Sabercat-Robotics-4146-FRC/Master-CAD-2017/images/Drive Module.jpeg

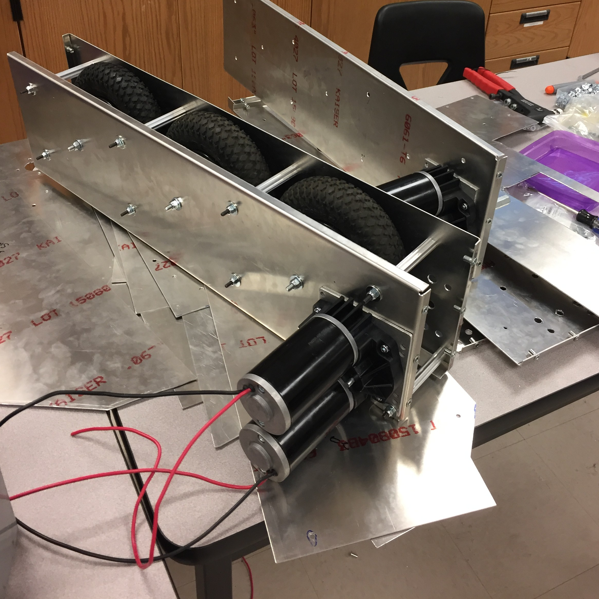
images/Drive Module.jpeg
