Sabercat-Robotics-4146-FRC/Master-CAD-2017/images/image01.png

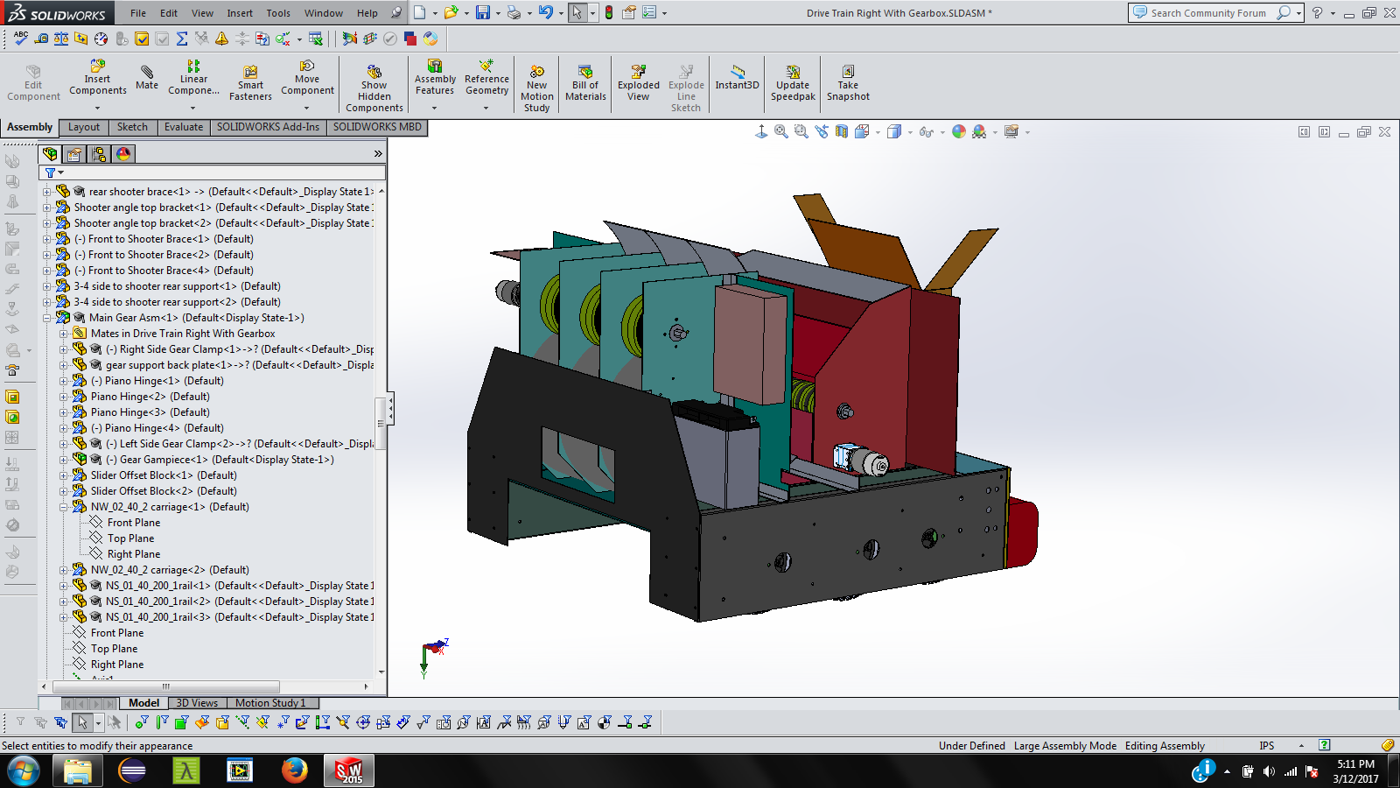
images/image01.png
