Sabercat-Robotics-4146-FRC/Master-CAD-2017/images/image02.png

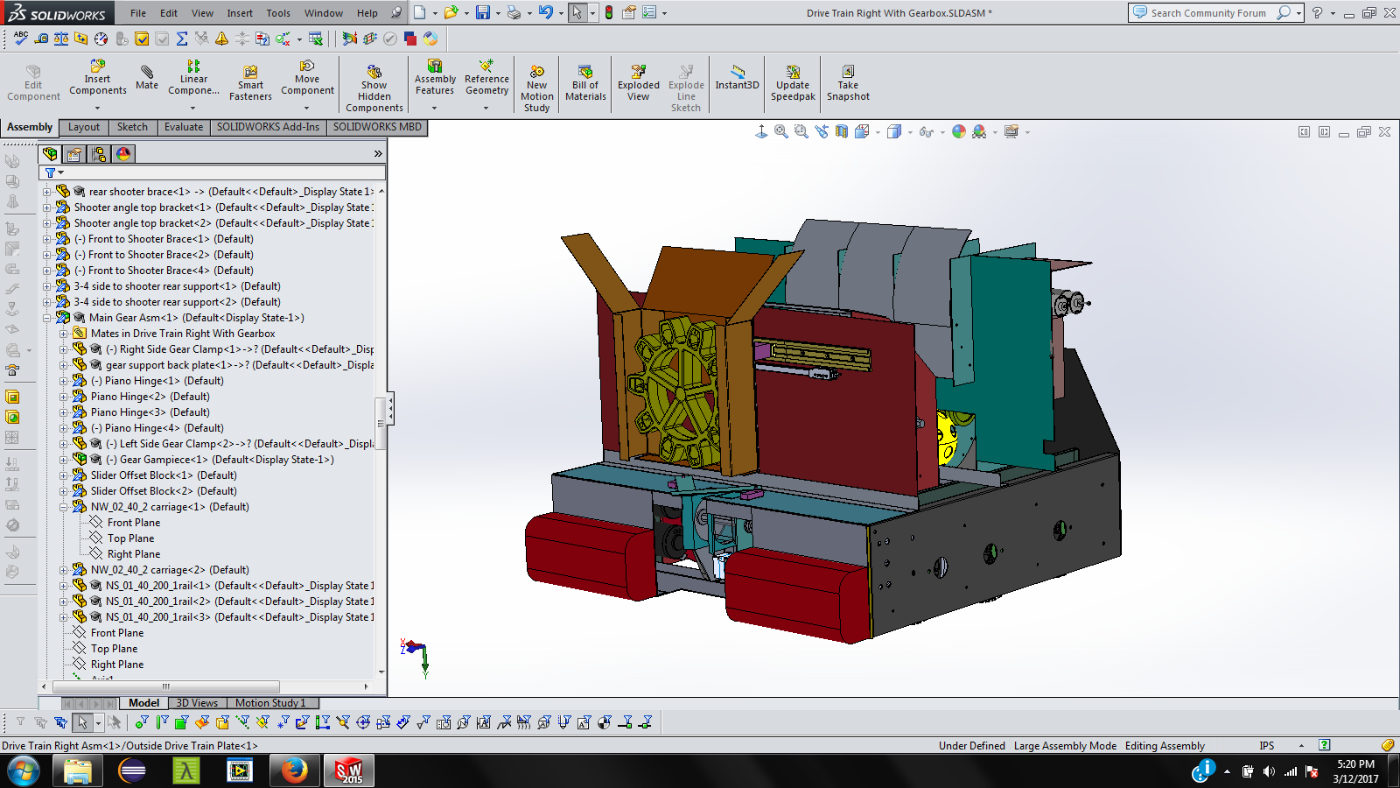
images/image02.png
