Sabercat-Robotics-4146-FRC/Master-CAD-2017/images/image03.png

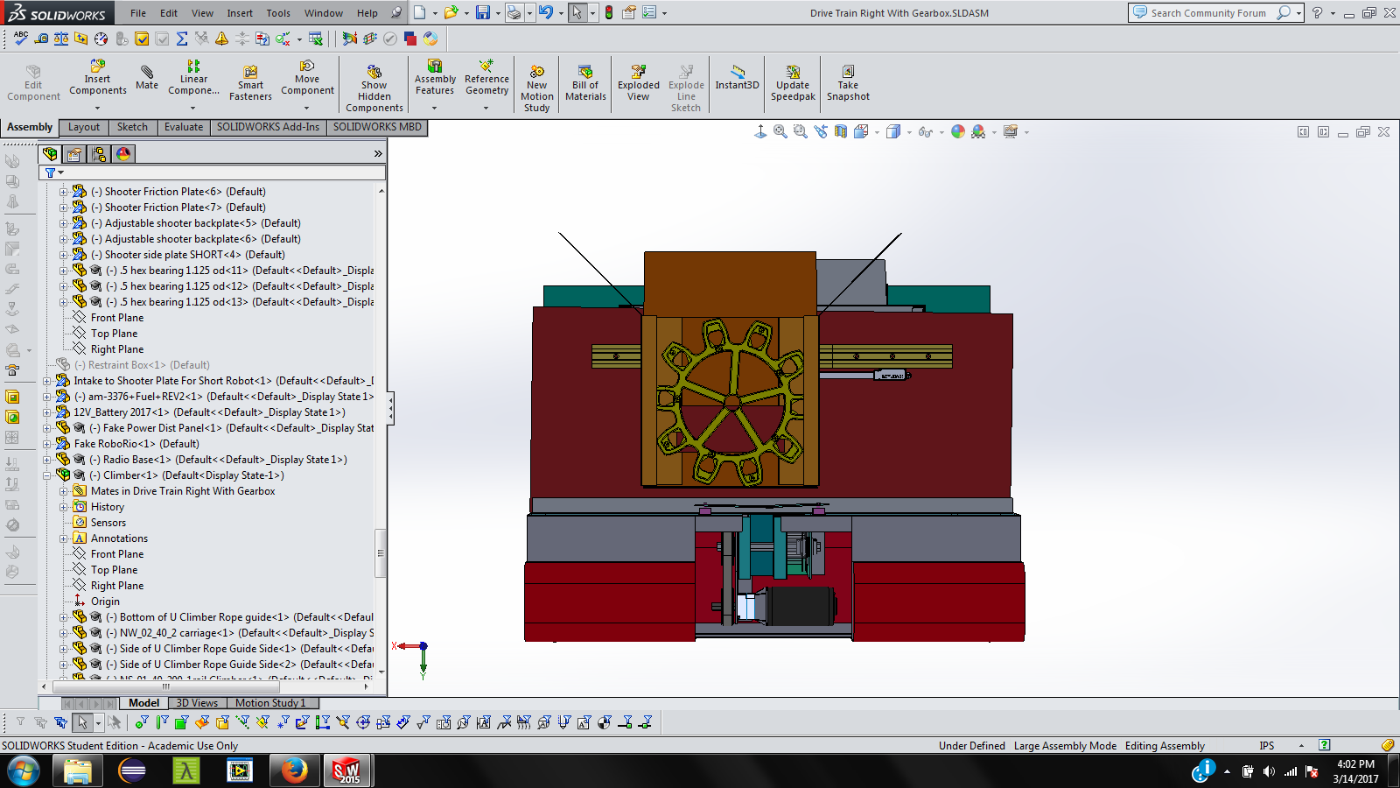
images/image03.png
