Sabercat-Robotics-4146-FRC/Master-CAD-2017/images/Pixy.jpg

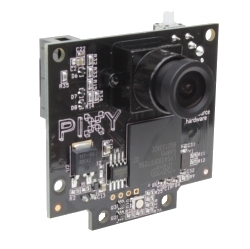
images/Pixy.jpg
