Sabercat-Robotics-4146-FRC/Master-CAD-2017/images/roboRIO-to-Pixy SPI connection configuration.jpg

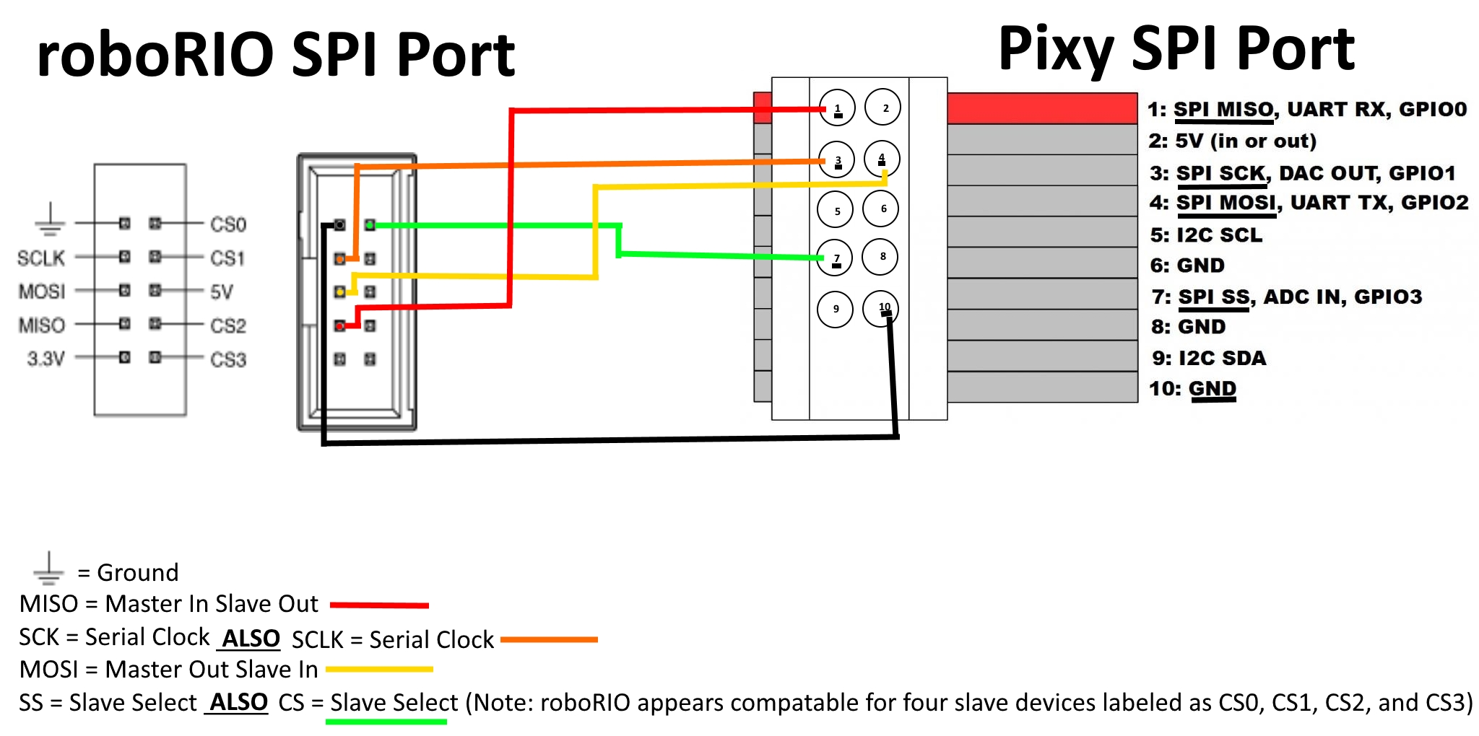
images/roboRIO-to-Pixy SPI connection configuration.jpg
