Sabercat-Robotics-4146-FRC/Master-CAD-2017/images/Robot Iso View crop.png

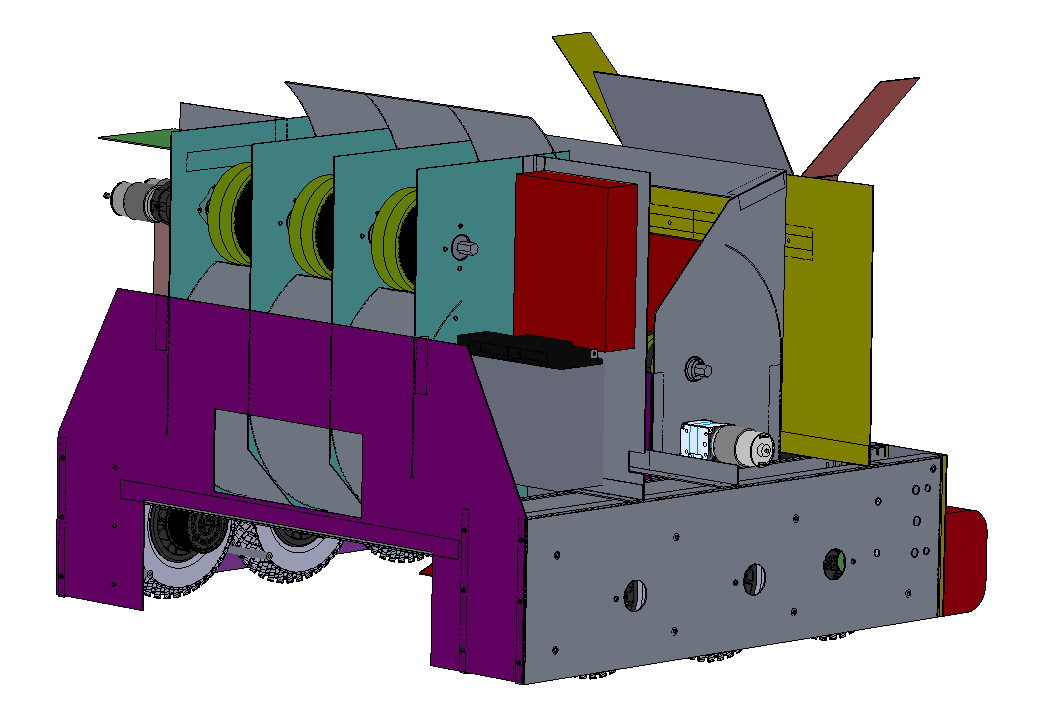
images/Robot Iso View crop.png
