Sabercat-Robotics-4146-FRC/Master-CAD-2017/Intake.SLDASM

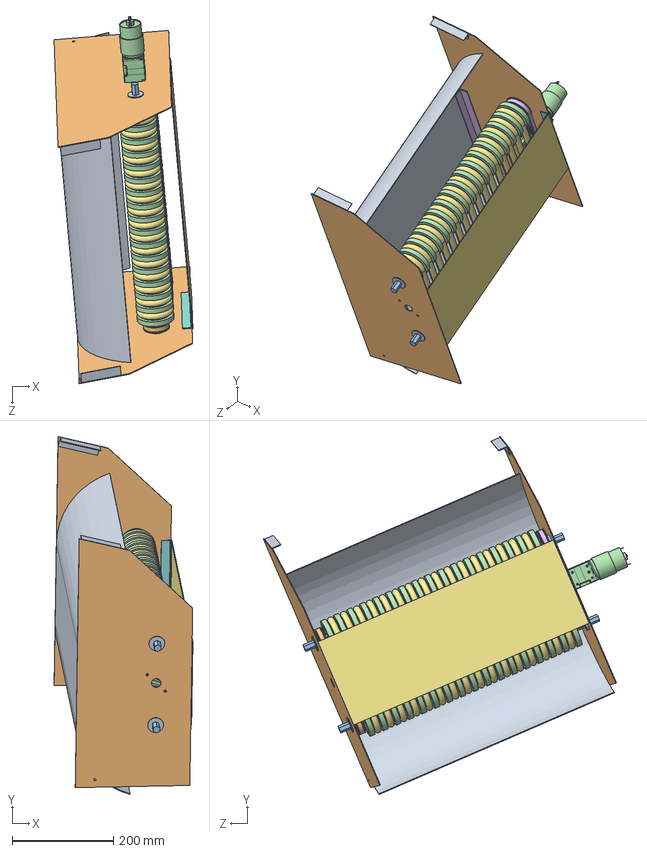
[picture p15: CAD file, 2017-07-01]
Intake.SLDASM
274.3 x 706.9 x 725.6 mm
Intake Backing Plate
Intake Side Plate x 2
Hex Shaft 22in for intake x 2
Banebots T40P 2-875 x 34
Banebots T40P 1-875 x 32
Intake Box Spine x 2
Intake Front Plate
Intake Box Front Rail x 2
.5 hex bearing 1.125 od x 4
Intake Drive Belt
VEXpro_VersaPlanetary_with_RS775
Primary Intake Drive Belt
Conveyor Tube Belt x 16
1-2 Intake brace x 2
3-4 brace for top intake x 2
