Sabercat-Robotics-4146-FRC/Master-CAD-2017/Pneumatic Wheel.SLDASM

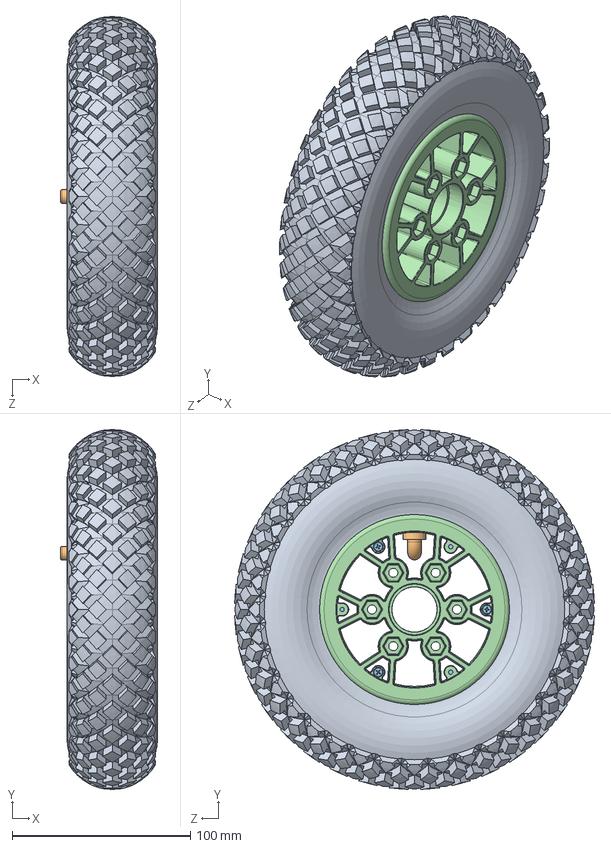
[picture p16: CAD file, 2017-07-01]
Pneumatic Wheel.SLDASM
54.4 x 202.1 x 202.1 mm
Tire
Valve
#4x1.00, Plastic Thread Rolling Screw, Pan Head, Cross Recessed, Zinc Plated (Plastic Applications)_ x 6
Hub x 2
