Sabercat-Robotics-4146-FRC/Master-CAD-2017/217-4008-STEP-20140807.SLDASM

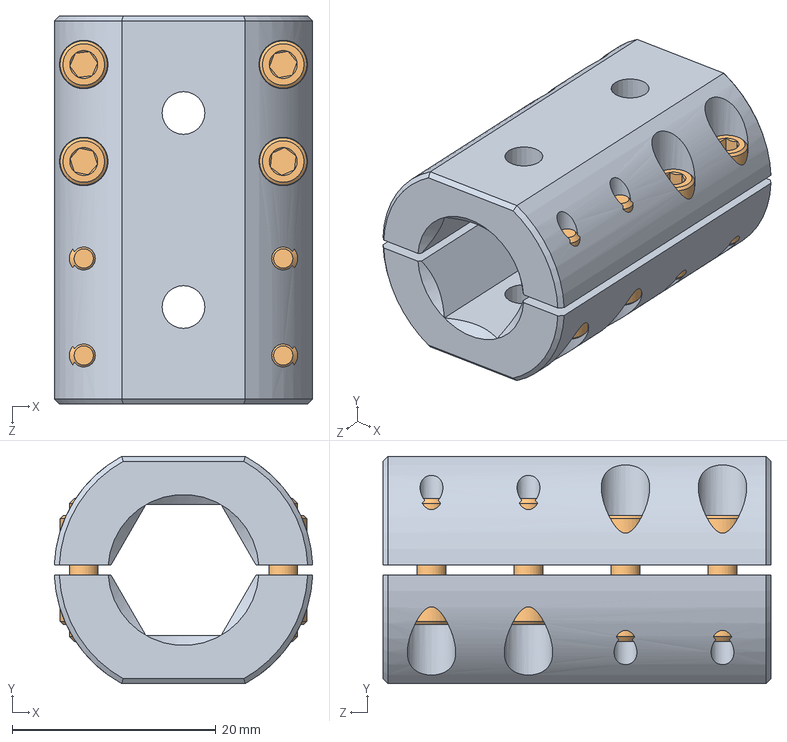
[picture p17: CAD file, 2017-07-01]
217-4008-STEP-20140807.SLDASM
25.4 x 22.3 x 38.1 mm
217-4008-001 Rev1 x 2
217-4008-002 Rev1_91251A108 x 8
