Sabercat-Robotics-4146-FRC/Master-CAD-2017/Snow Blower Motor True.SLDASM

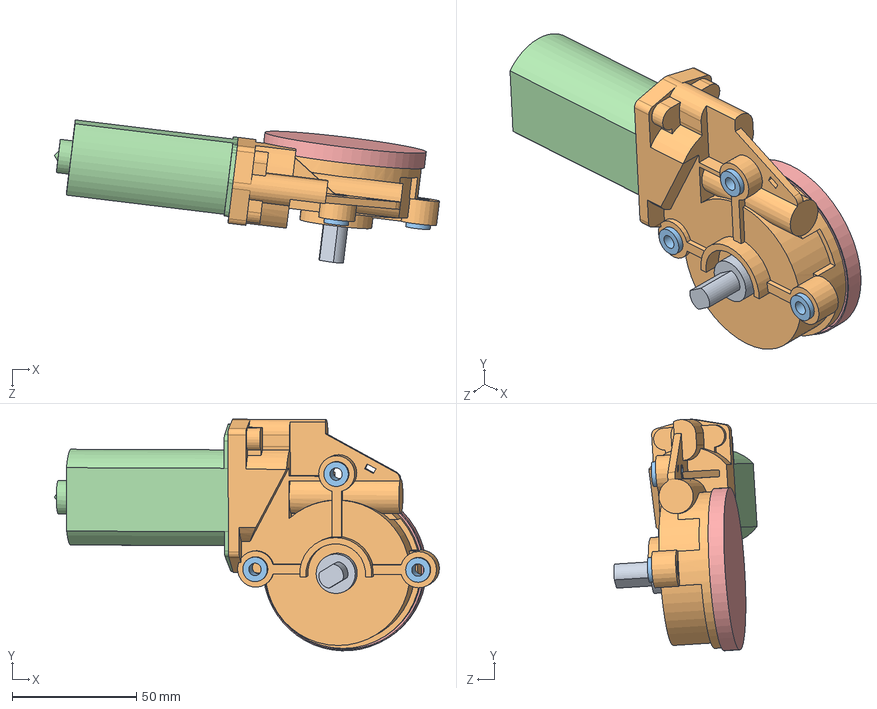
[picture p18: CAD file, 2017-07-01]
Snow Blower Motor True.SLDASM
154.8 x 93.1 x 57.6 mm
AM-2235 output shaft
AM-2235 gearbox housing
AM-2235 threaded insert x 3
AM-2235 motor
AM-2235 gear cap
