Sabercat-Robotics-4146-FRC/Master-CAD-2017/Main Gear Asm.SLDASM

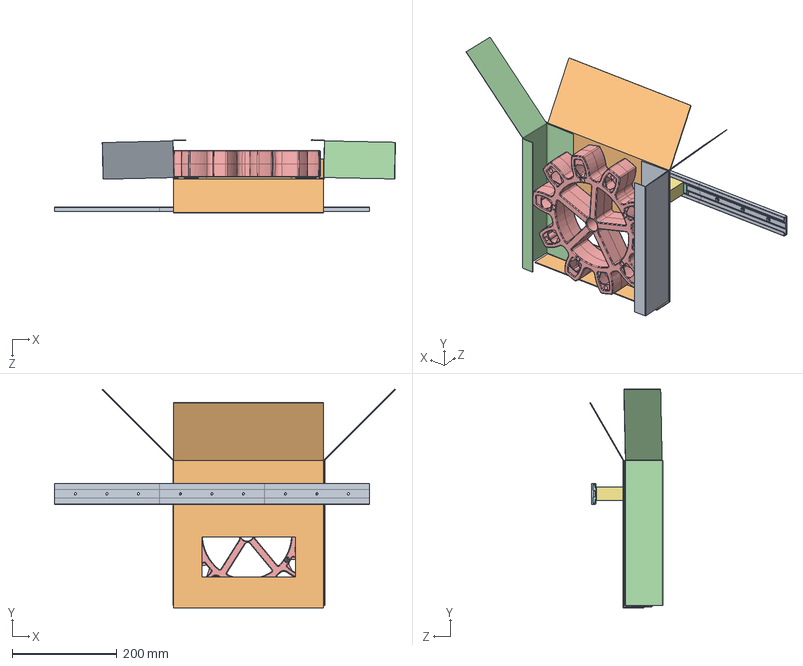
[picture p19: CAD file, 2017-07-01]
Main Gear Asm.SLDASM
649.7 x 416.4 x 139.9 mm
Right Side Gear Clamp
gear support back plate
Piano Hinge x 4
Left Side Gear Clamp
ip-3302 10T gear x 2
am-1291 screw_90190A196 x 20
Slider Offset Block x 2
NW_02_40_2 carriage x 2
NS_01_40_200_1rail x 3
