Sabercat-Robotics-4146-FRC/Master-CAD-2017/Climber Guide.SLDASM

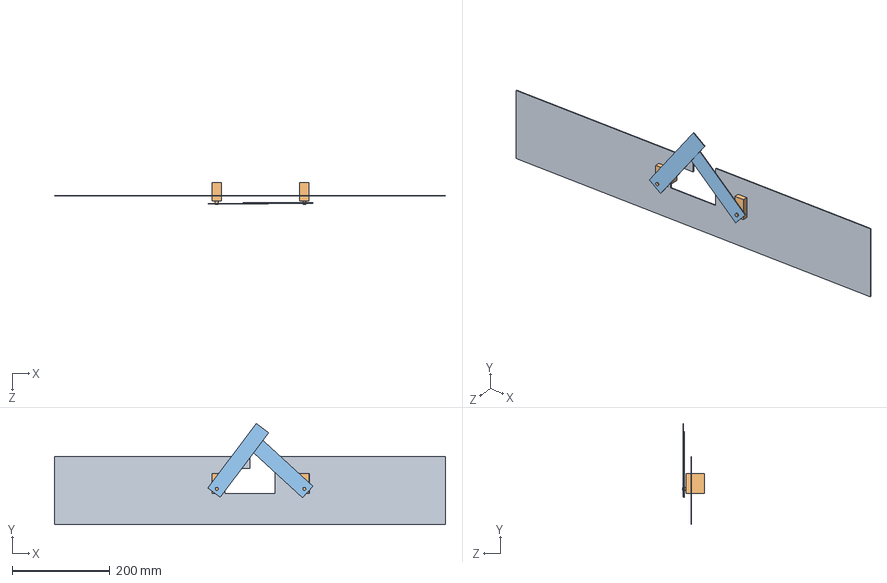
[picture p20: CAD file, 2017-07-01]
Climber Guide.SLDASM
800.1 x 206.9 x 46.0 mm
Climber Guide Baseplate
Fake Servo Tactic TSX45 x 2
Servo Arm x 2
