Sabercat-Robotics-4146-FRC/Master-CAD-2017/CIM motor with versa planetary adapter.SLDASM

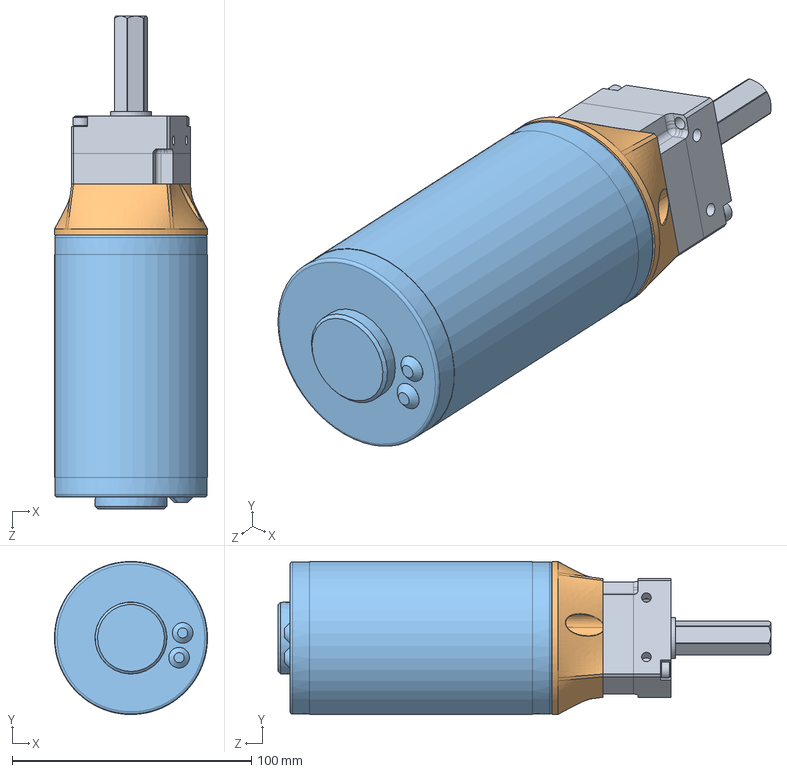
[picture p21: CAD file, 2017-07-01]
CIM motor with versa planetary adapter.SLDASM
64.0 x 64.0 x 206.2 mm
Climber Gearbox for CIM
217-4018 Versa Planetary CIM Adapter
CIM MOTOR
