Sabercat-Robotics-4146-FRC/Master-CAD-2017/Gear Gampiece.SLDASM

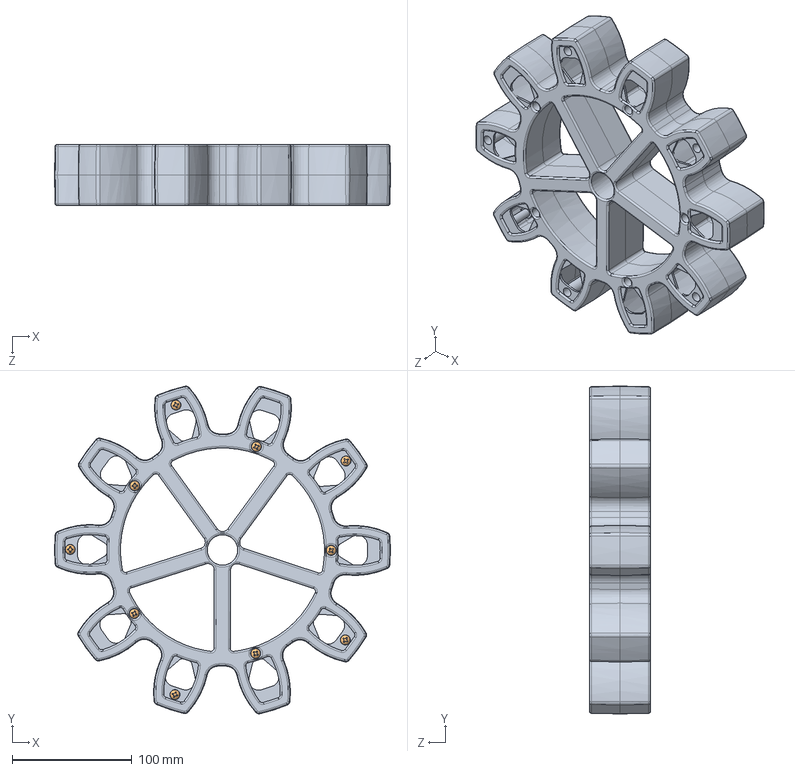
[picture p22: CAD file, 2017-07-01]
Gear Gampiece.SLDASM
280.3 x 273.4 x 50.8 mm
ip-3302 10T gear x 2
am-1291 screw_90190A196 x 20
