Sabercat-Robotics-4146-FRC/Master-CAD-2017/servo.SLDASM

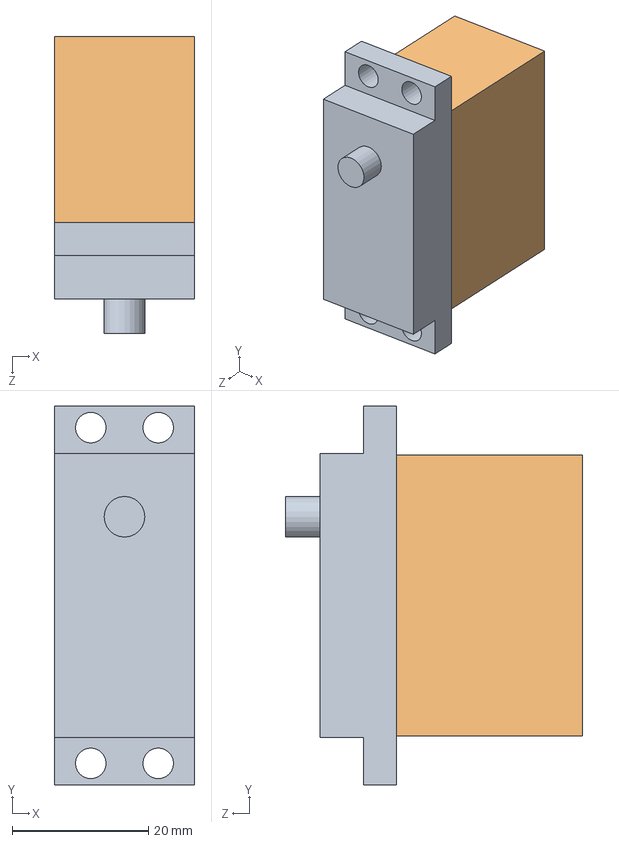
[picture p23: CAD file, 2017-07-01]
servo.SLDASM
20.6 x 55.6 x 43.6 mm
Servo mounting block
Servo base block
