Sabercat-Robotics-4146-FRC/Master-CAD-2017/Wheel Asm.SLDASM

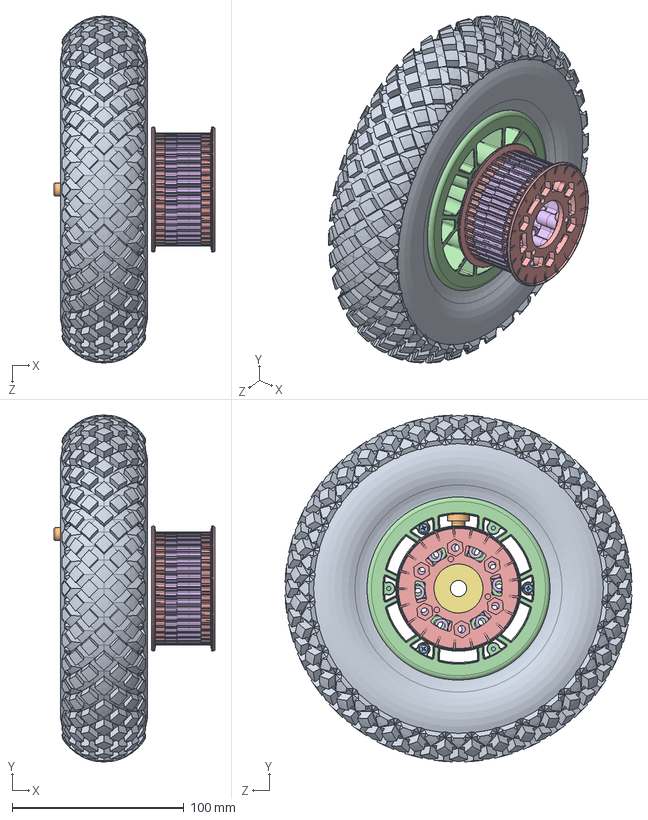
[picture p24: CAD file, 2017-07-01]
Wheel Asm.SLDASM
93.7 x 202.1 x 202.1 mm
Tire
Valve
#4x1.00, Plastic Thread Rolling Screw, Pan Head, Cross Recessed, Zinc Plated (Plastic Applications)_ x 6
Hub x 2
Outer Pulley x 2
Center Pulley x 3
1.125 od .375 id bearing x 2
