Sabercat-Robotics-4146-FRC/Master-CAD-2017/Toughbox-mini.SLDASM

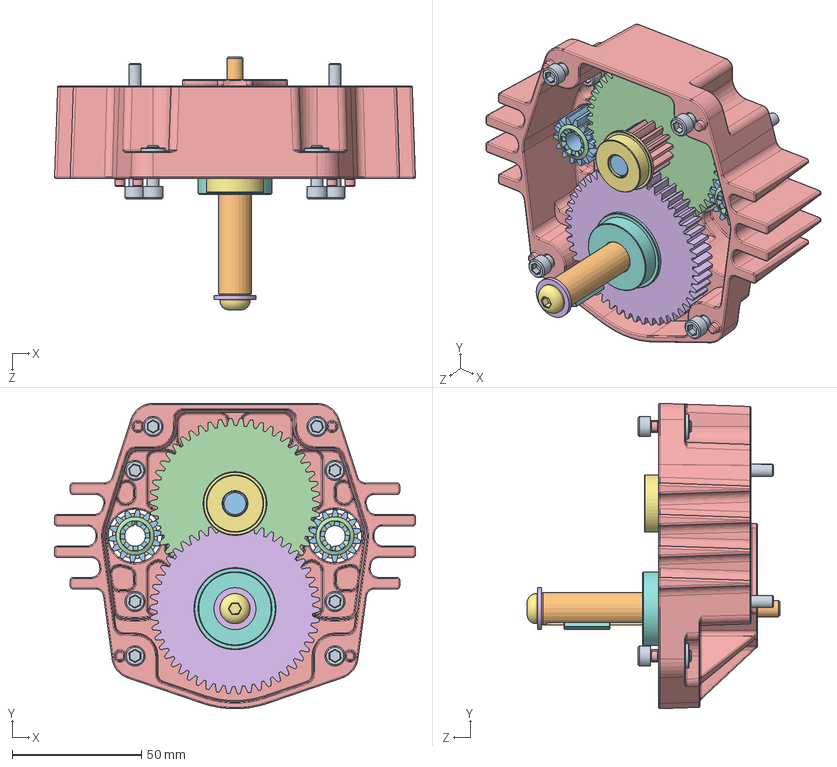
[picture p25: CAD file, 2017-07-01]
Toughbox-mini.SLDASM
139.9 x 118.3 x 98.0 mm
r6zz x 2
Toughbox_d03
Toughbox_d07
Toughbox_d05
Toughbox_d08
Toughbox_d06
fr-6-zz
fr-8-zz
10-32_nylock_nut x 4
5-16_washer x 4
Toughbox_d09 x 2
8mm_spring_clip x 2
Toughbox-mini_d01-5-12
250_washer
14-20x0500_bhcs
125x124x700_key
10-32x0625_shcs x 8
