Sabercat-Robotics-4146-FRC/Master-CAD-2017/Climber.SLDASM

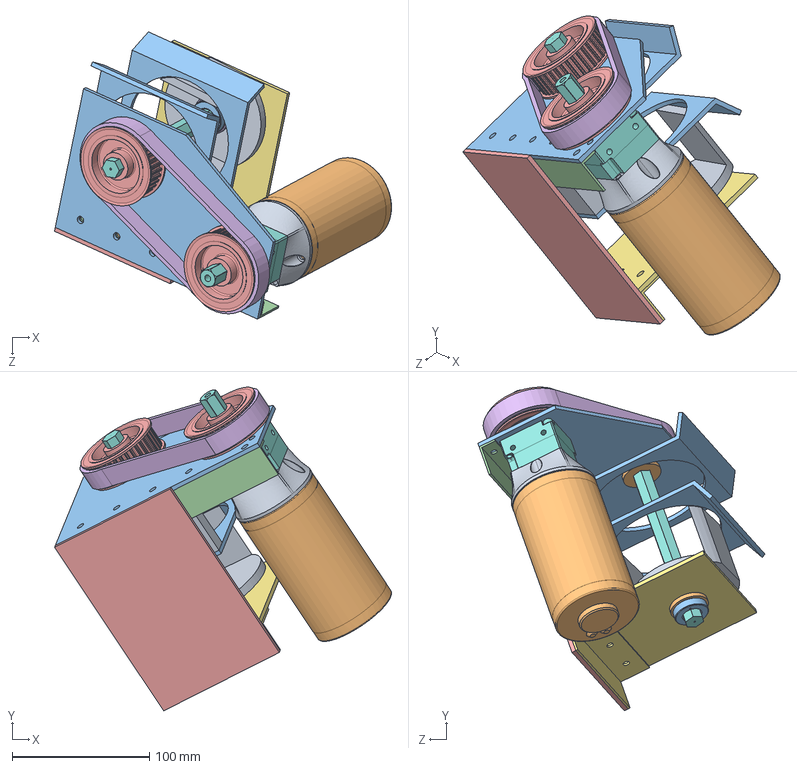
[picture p26: CAD file, 2017-07-01]
Climber.SLDASM
245.1 x 235.5 x 209.0 mm
Bottom of U Climber Rope guide
NW_02_40_2 carriage
Side of U Climber Rope Guide Side x 2
NS_01_40_200_1rail Climber
Climber Baseplate
Versa Hub 1-2 Hex
Climber Rope Sideplate
Climber Hex Shaft
Climber Rope Winder
.5 hex bearing 1.125 od x 2
217-2737 Shaft Collar x 2
Angle Piece for Climber Side Plate
217-3232 Timing Pulley 36T 15mm x 2
Climber Belt 60T (36T pulley)
Angle Piece for Climber Side Plate uncut
Climber Gearbox for CIM
217-4018 Versa Planetary CIM Adapter
CIM MOTOR
Climber Rope Sideplate with motor
