Sabercat-Robotics-4146-FRC/Master-CAD-2017/2017 Robot Intake Asm.SLDASM

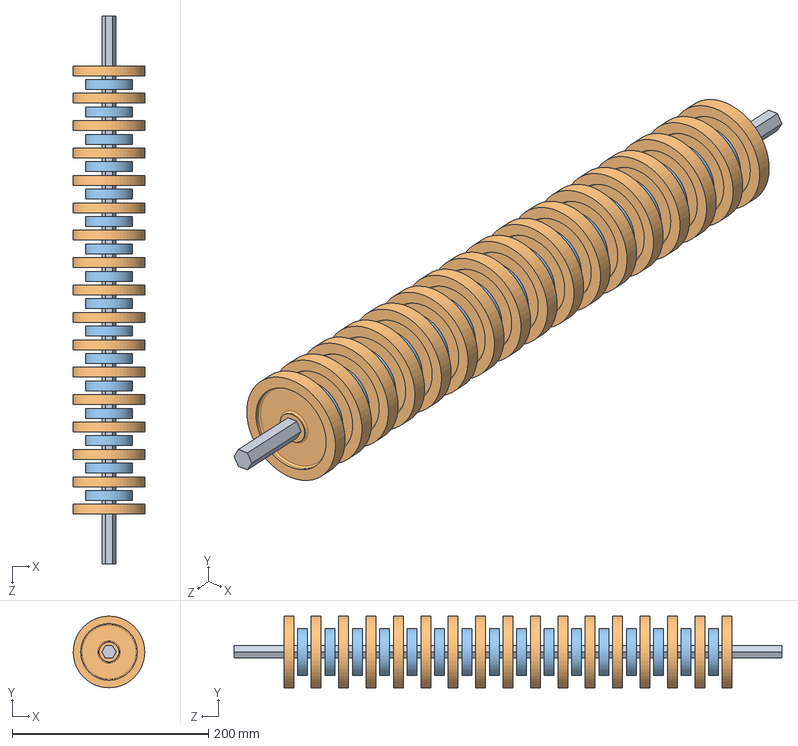
[picture p27: CAD file, 2017-07-01]
2017 Robot Intake Asm.SLDASM
73.0 x 73.0 x 558.8 mm
Hex Shaft 22in for intake
Banebots T40P 2-875 x 17
Banebots T40P 1-875 x 16
