Sabercat-Robotics-4146-FRC/Master-CAD-2017/Drive Train Left Asm.SLDASM

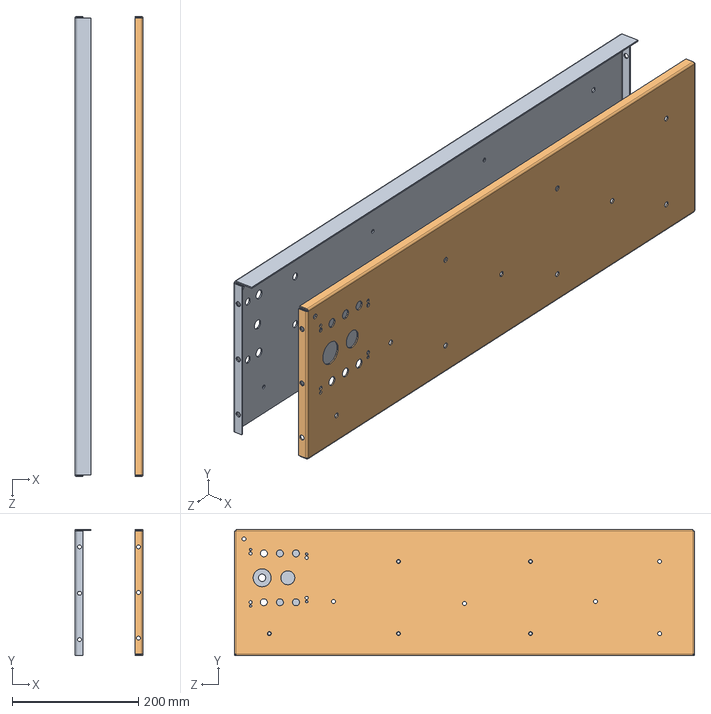
[picture p28: CAD file, 2017-07-01]
Drive Train Left Asm.SLDASM
108.4 x 200.2 x 728.6 mm
Outside Drive Train Plate Left
Inner Drive Train Plate Left
