Sabercat-Robotics-4146-FRC/Master-CAD-2017/217-3141-RS775-STEP.SLDASM

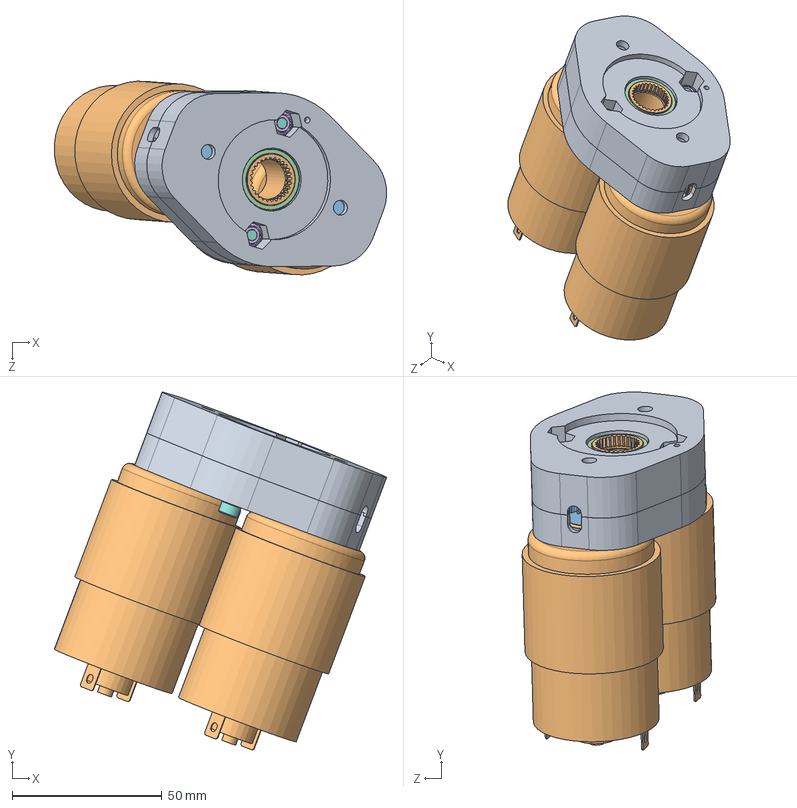
[picture p29: CAD file, 2017-07-01]
217-3141-RS775-STEP.SLDASM
110.8 x 119.3 x 64.6 mm
217-3141-001 Rev1
217-3141-007 Rev1_30T 32DP
217-3141-006 Rev1_30T 32DP x 2
SSS1032-0188-ZB x 2
NUT-832-NYLOCK x 2
SSA_SSAM4-0010ZC x 4
SSA_SSA0832-0750ZC x 2
217-3141-004 Rev1
BB RS775-18V x 2
217-2625-013 Rev1 x 2
