Sabercat-Robotics-4146-FRC/Master-CAD-2017/Climber Rope Sideplate with motor.SLDPRT

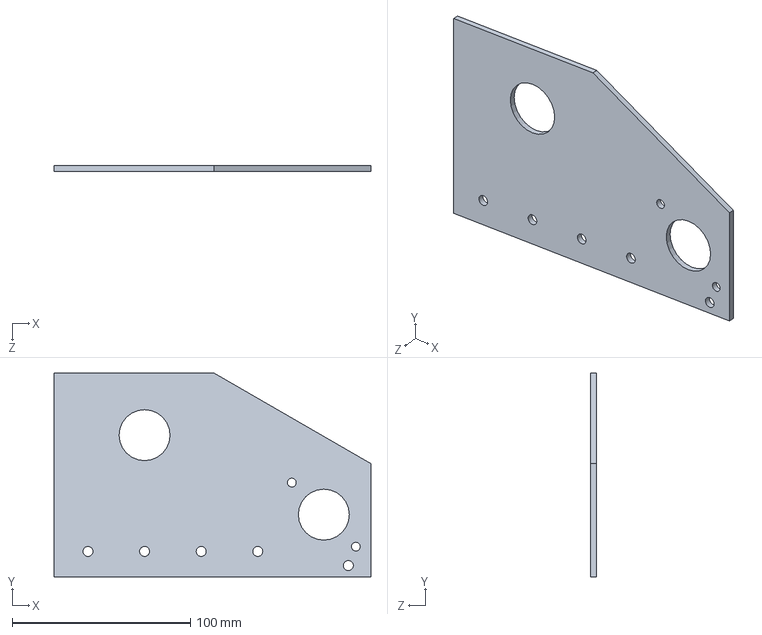
[picture p30: CAD file, 2017-07-01]
Climber Rope Sideplate with motor.SLDPRT
177.8 x 114.3 x 3.17 mm
