Sabercat-Robotics-4146-FRC/Master-CAD-2017/Back Belly Pan Diagonal.SLDPRT

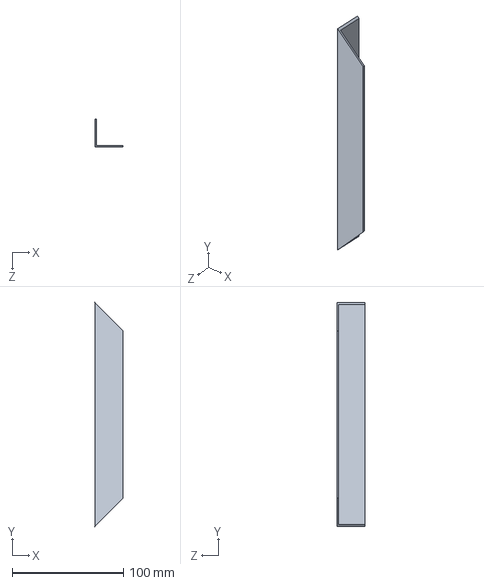
[picture p31: CAD file, 2017-07-01]
Back Belly Pan Diagonal.SLDPRT
25.4 x 200.9 x 25.4 mm
