Sabercat-Robotics-4146-FRC/Master-CAD-2017/rear shooter brace.SLDPRT

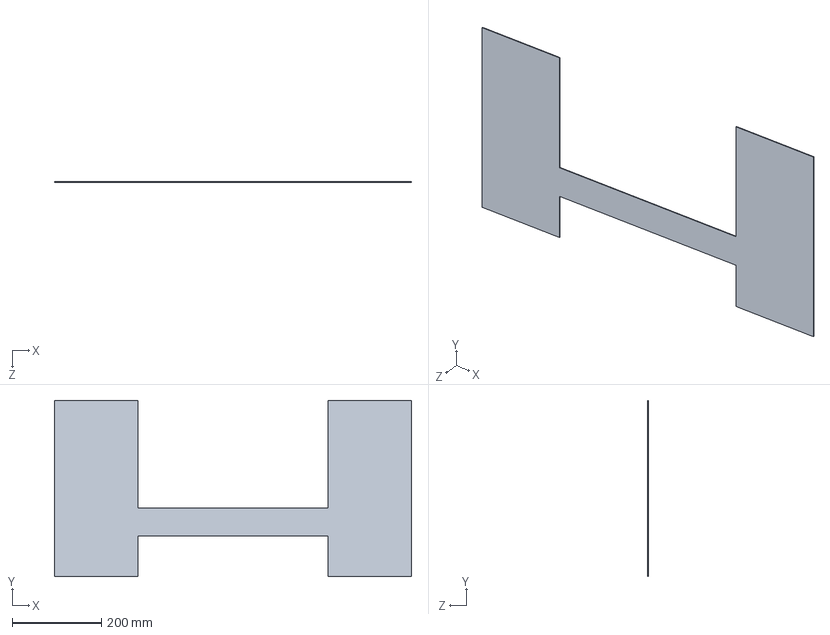
[picture p32: CAD file, 2017-07-01]
rear shooter brace.SLDPRT
800.1 x 394.5 x 1.59 mm
