Sabercat-Robotics-4146-FRC/Master-CAD-2017/Hex Shaft 22in for intake.SLDPRT

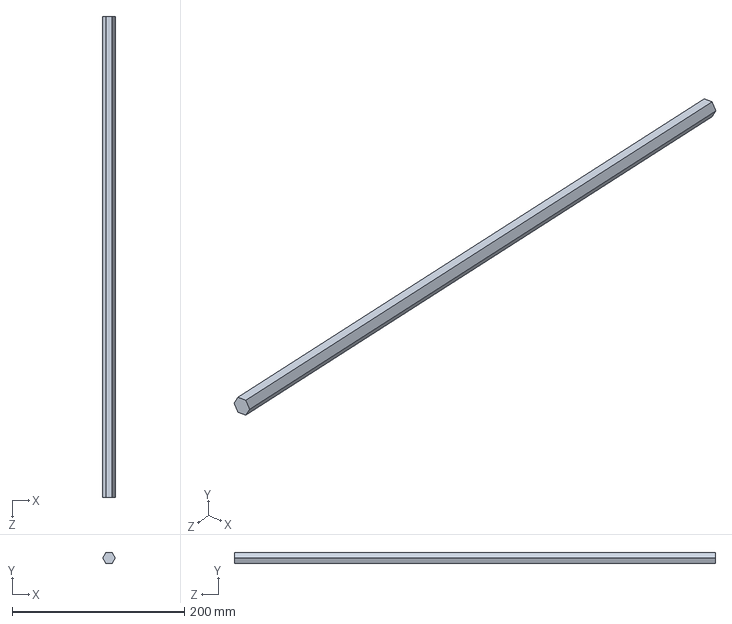
[picture p33: CAD file, 2017-07-01]
Hex Shaft 22in for intake.SLDPRT
14.7 x 12.7 x 558.8 mm
