Sabercat-Robotics-4146-FRC/Master-CAD-2017/Right Side Gear Clamp.SLDPRT

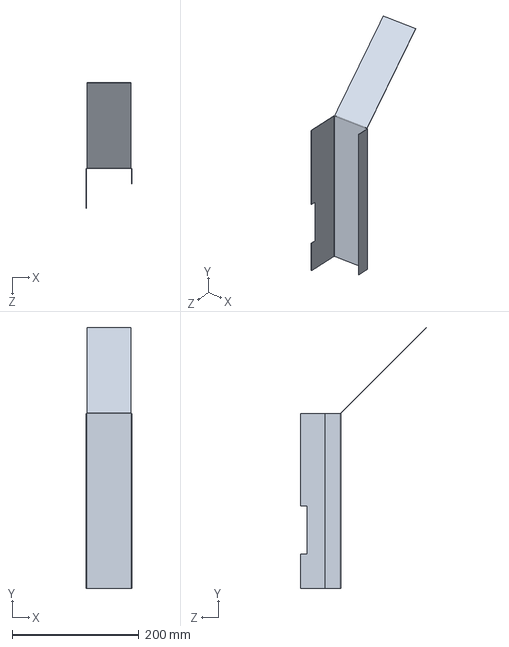
[picture p34: CAD file, 2017-07-01]
Right Side Gear Clamp.SLDPRT
72.6 x 411.1 x 198.0 mm
