Sabercat-Robotics-4146-FRC/Master-CAD-2017/Adjustable shooter backplate.SLDPRT

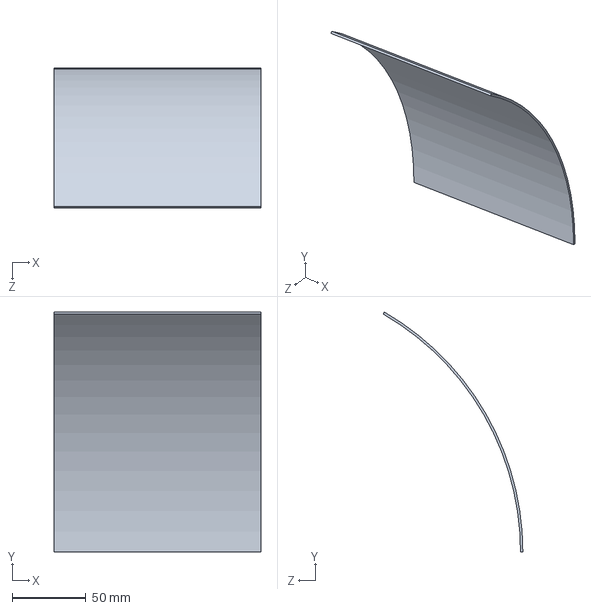
[picture p35: CAD file, 2017-07-01]
Adjustable shooter backplate.SLDPRT
139.7 x 162.2 x 94.4 mm
