Sabercat-Robotics-4146-FRC/Master-CAD-2017/217-4018 Versa Planetary CIM Adapter.SLDPRT

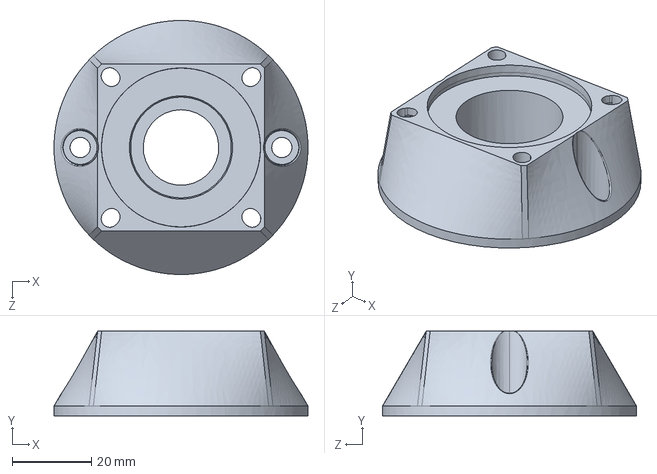
[picture p36: CAD file, 2017-07-01]
217-4018 Versa Planetary CIM Adapter.SLDPRT
64.0 x 21.4 x 64.0 mm
