Sabercat-Robotics-4146-FRC/Master-CAD-2017/NW_02_40_2 carriage.SLDPRT

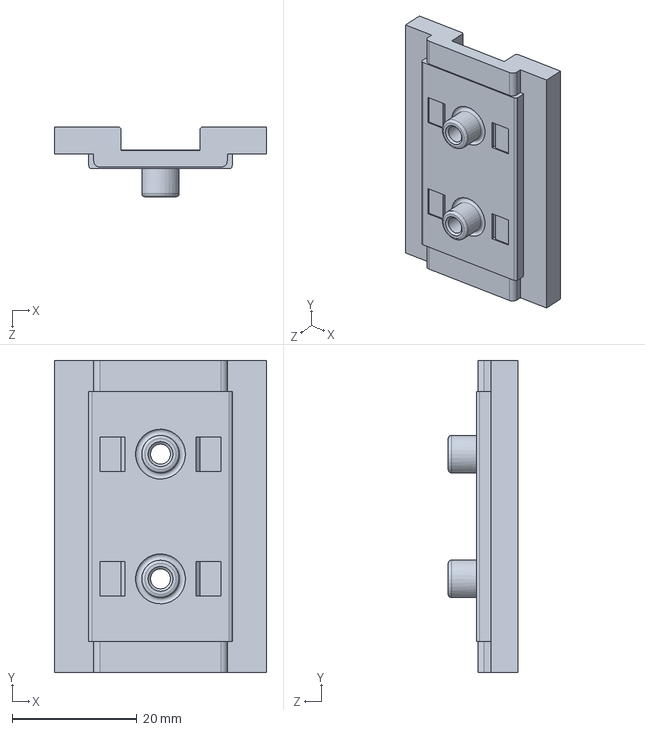
[picture p37: CAD file, 2017-07-01]
NW_02_40_2 carriage.SLDPRT
34.0 x 50.0 x 11.2 mm
