Sabercat-Robotics-4146-FRC/Master-CAD-2017/Restraint Box.SLDPRT

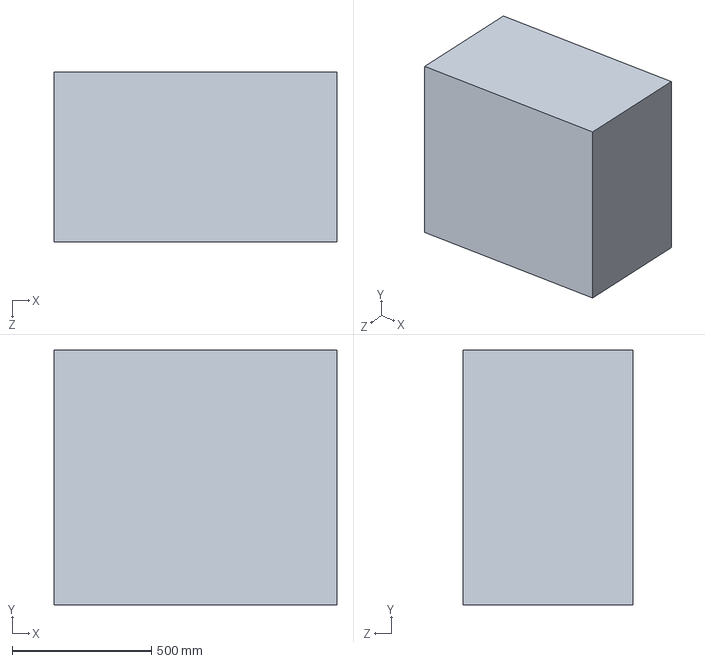
[picture p38: CAD file, 2017-07-01]
Restraint Box.SLDPRT
1016.0 x 914.4 x 609.6 mm
