Sabercat-Robotics-4146-FRC/Master-CAD-2017/Gear_v2_mock pivot hinge leaf only.SLDPRT

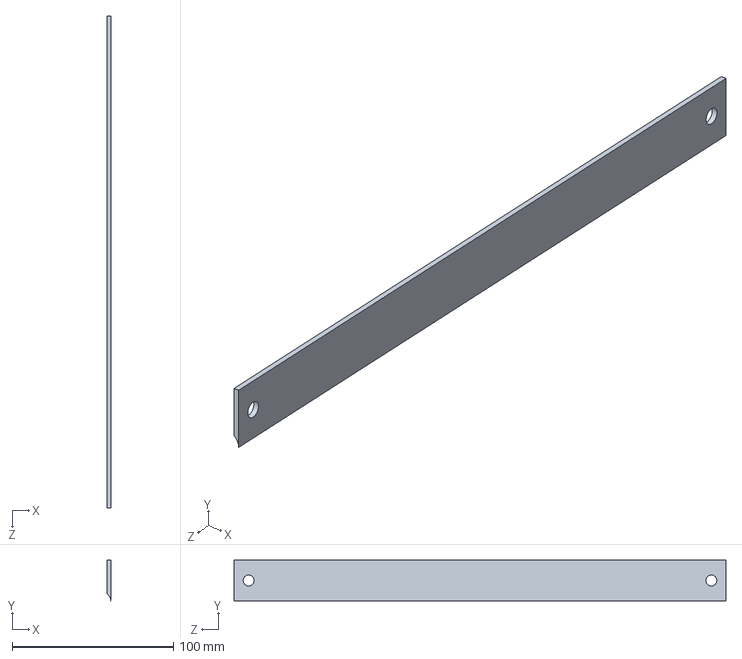
[picture p39: CAD file, 2017-07-01]
Gear_v2_mock pivot hinge leaf only.SLDPRT
2.29 x 25.4 x 304.8 mm
