Sabercat-Robotics-4146-FRC/Master-CAD-2017/CIM MOTOR.SLDPRT

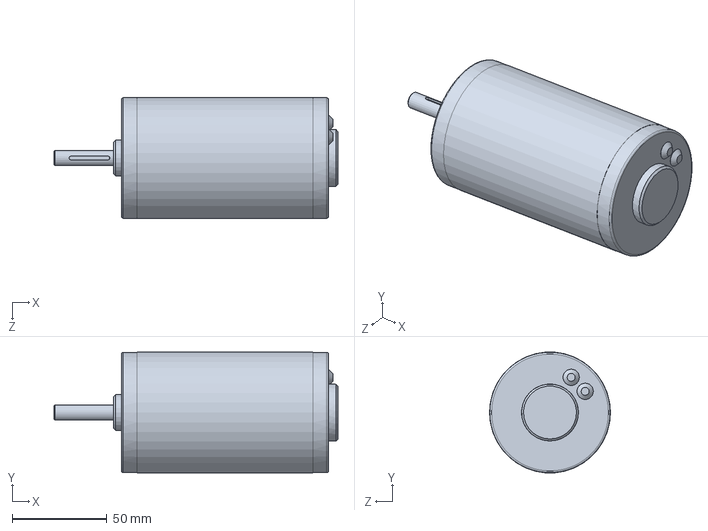
[picture p40: CAD file, 2017-07-01]
CIM MOTOR.SLDPRT
150.2 x 63.8 x 64.0 mm
