Sabercat-Robotics-4146-FRC/Master-CAD-2017/Versa Hub 1-2 Hex.SLDPRT

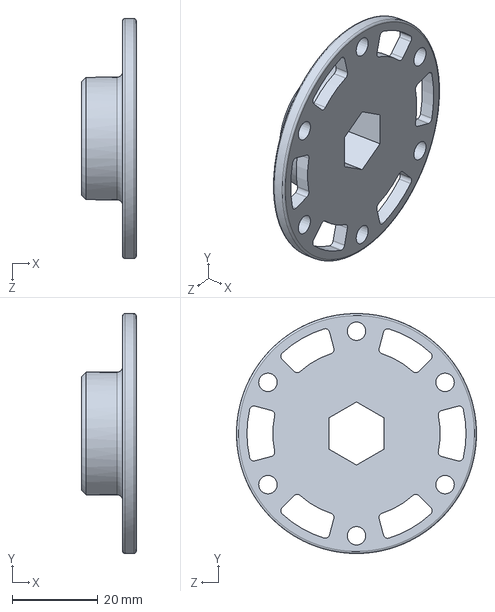
[picture p41: CAD file, 2017-07-01]
Versa Hub 1-2 Hex.SLDPRT
12.7 x 55.9 x 55.9 mm
