Sabercat-Robotics-4146-FRC/Master-CAD-2017/Toughbox-mini_d01-5-12.sldprt

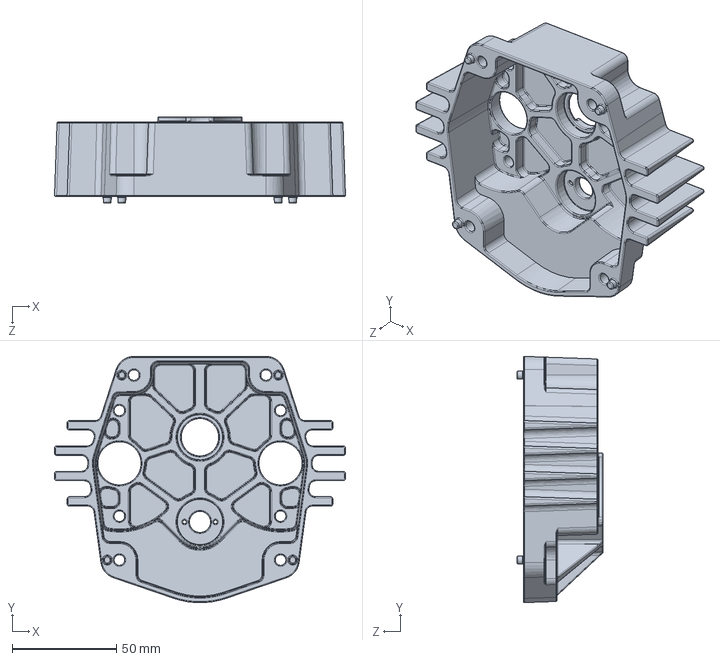
[picture p42: CAD file, 2017-07-01]
Toughbox-mini_d01-5-12.sldprt
139.9 x 118.3 x 41.5 mm
