Sabercat-Robotics-4146-FRC/Master-CAD-2017/am-3376+Fuel+REV2.SLDPRT

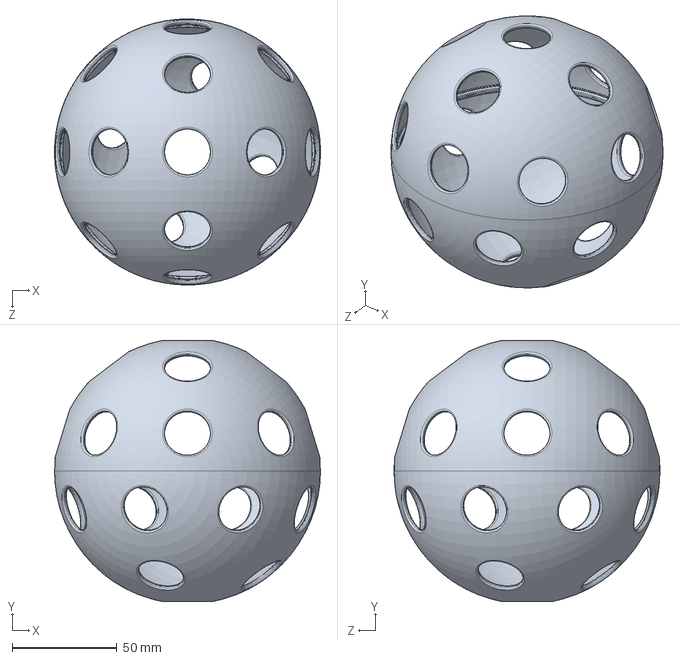
[picture p43: CAD file, 2017-07-01]
am-3376+Fuel+REV2.SLDPRT
127.0 x 124.8 x 127.0 mm
