Sabercat-Robotics-4146-FRC/Master-CAD-2017/Intake to Shooter Plate For Short Robot.SLDPRT

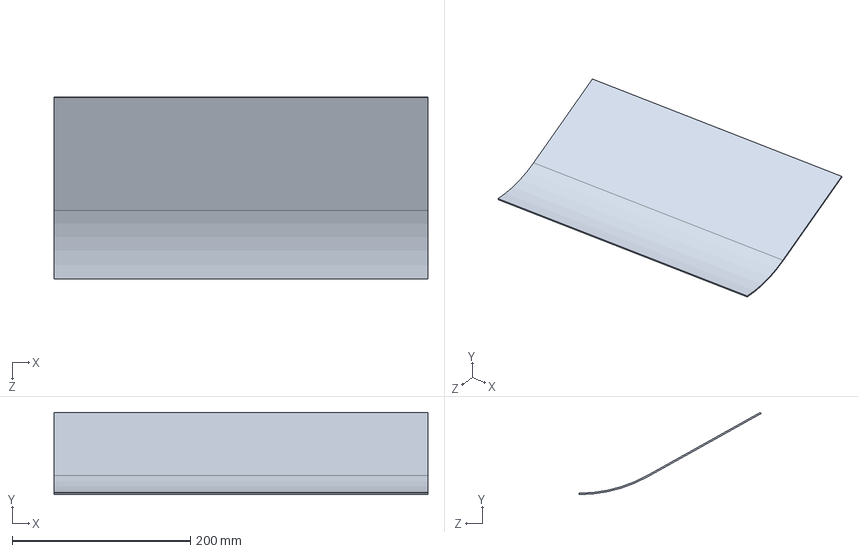
[picture p44: CAD file, 2017-07-01]
Intake to Shooter Plate For Short Robot.SLDPRT
419.1 x 92.1 x 204.0 mm
