Sabercat-Robotics-4146-FRC/Master-CAD-2017/Intake Box Spine.SLDPRT

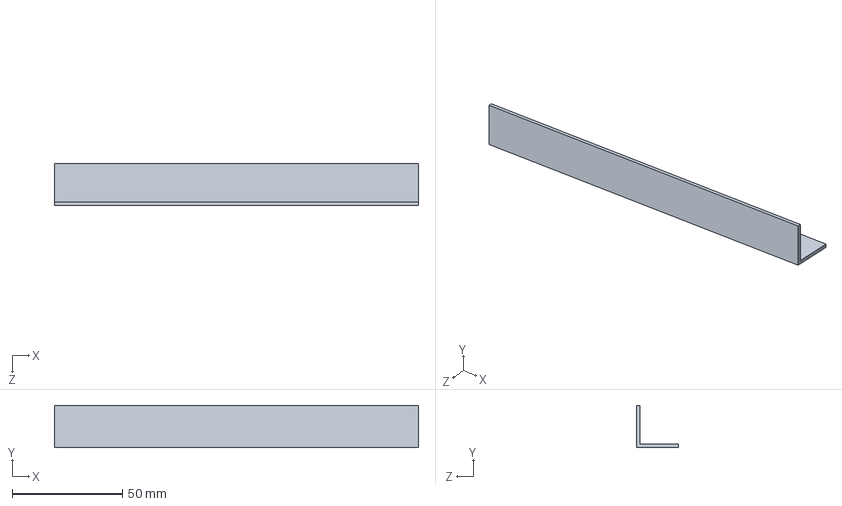
[picture p45: CAD file, 2017-07-01]
Intake Box Spine.SLDPRT
165.1 x 19.1 x 19.1 mm
