Sabercat-Robotics-4146-FRC/Master-CAD-2017/Servo Arm.SLDPRT

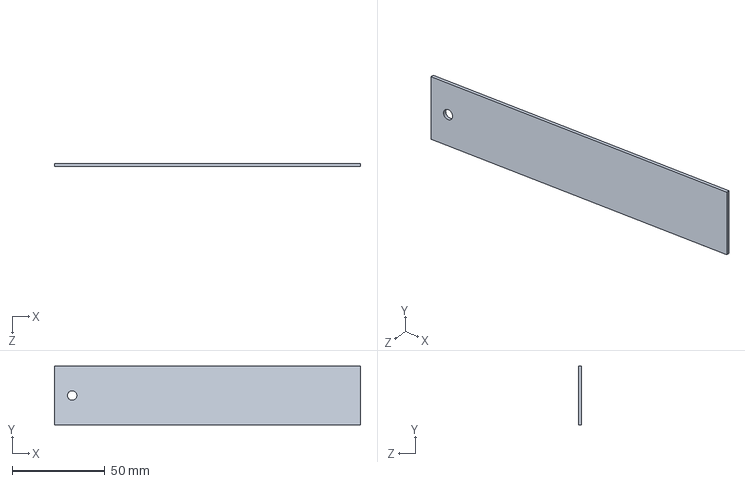
[picture p46: CAD file, 2017-07-01]
Servo Arm.SLDPRT
165.1 x 31.8 x 1.60 mm
