Sabercat-Robotics-4146-FRC/Master-CAD-2017/Shooter Feed Back Plate SHORT.SLDPRT

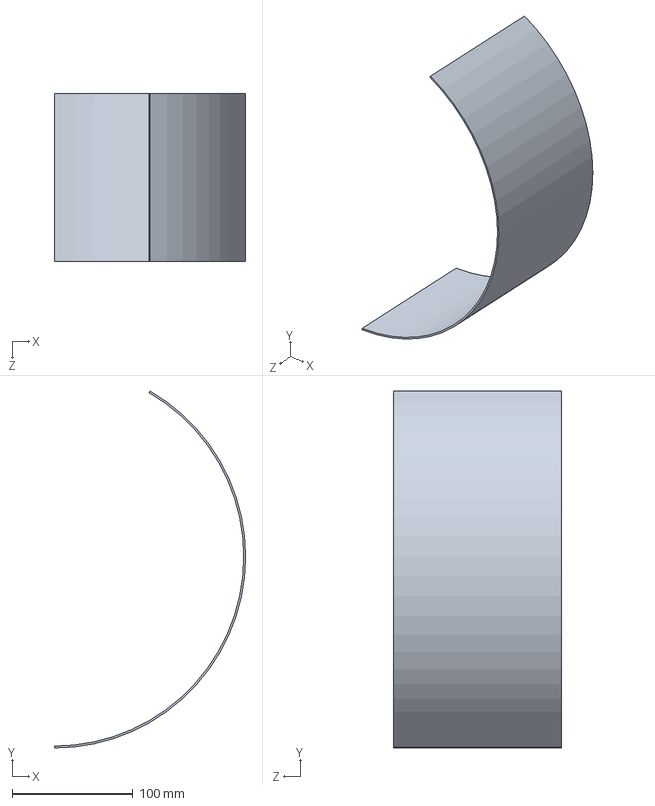
[picture p47: CAD file, 2017-07-01]
Shooter Feed Back Plate SHORT.SLDPRT
158.8 x 296.2 x 139.7 mm
