Sabercat-Robotics-4146-FRC/Master-CAD-2017/Intake Front Plate.SLDPRT

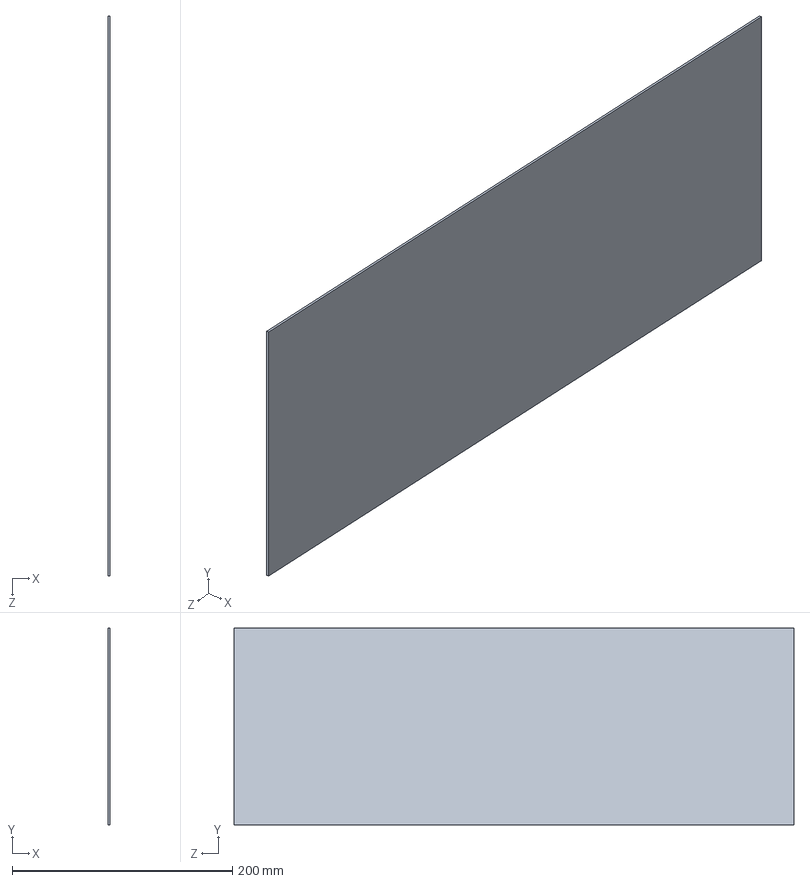
[picture p48: CAD file, 2017-07-01]
Intake Front Plate.SLDPRT
1.59 x 178.8 x 508.0 mm
