Sabercat-Robotics-4146-FRC/Master-CAD-2017/Intake Side Plate.SLDPRT

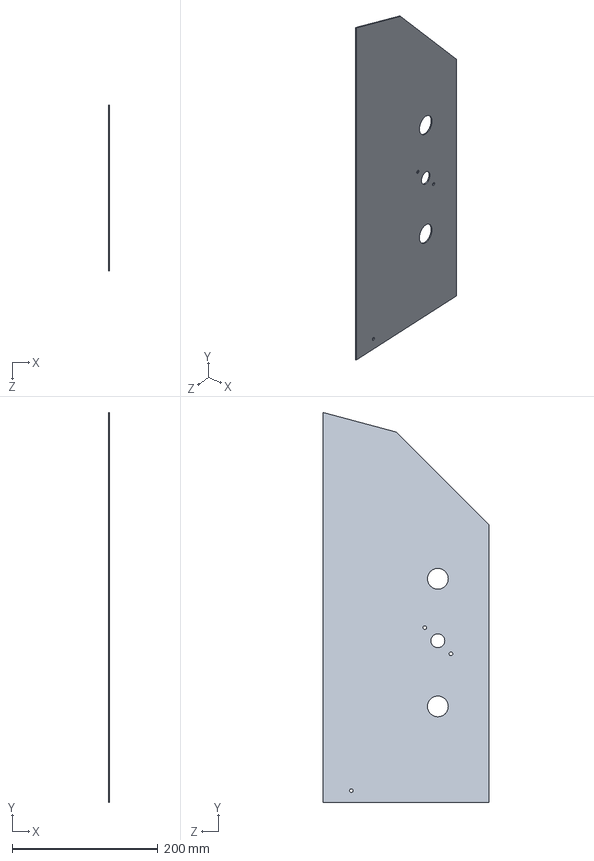
[picture p49: CAD file, 2017-07-01]
Intake Side Plate.SLDPRT
1.59 x 534.8 x 227.1 mm
