Sabercat-Robotics-4146-FRC/Master-CAD-2017/3-4 Door Connecting Bracket.SLDPRT

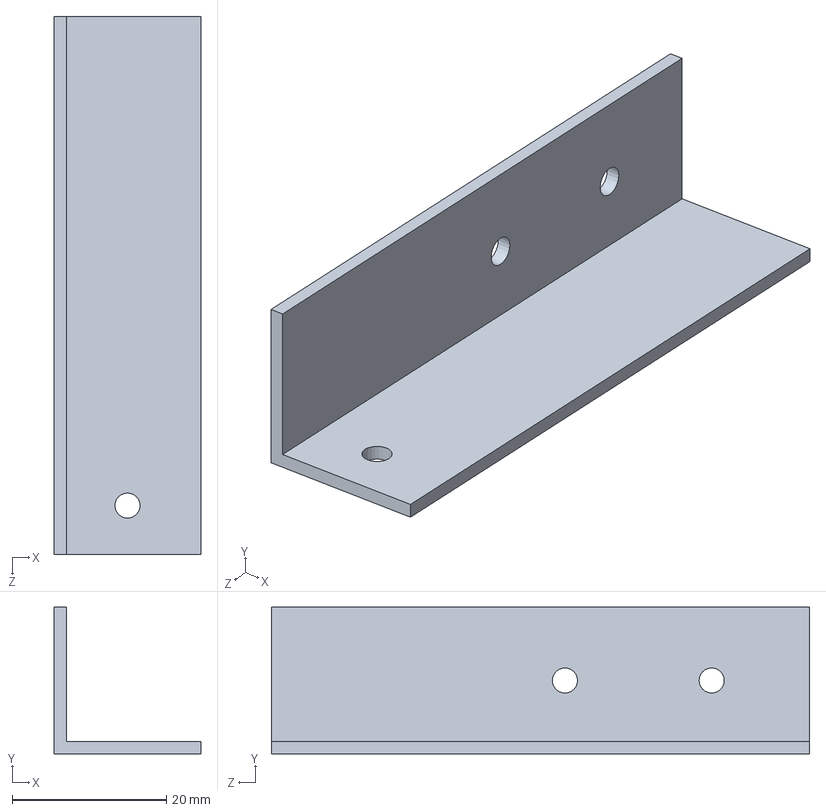
[picture p50: CAD file, 2017-07-01]
3-4 Door Connecting Bracket.SLDPRT
19.1 x 19.1 x 69.8 mm
