Sabercat-Robotics-4146-FRC/Master-CAD-2017/Climber Belt 60T (36T pulley).SLDPRT

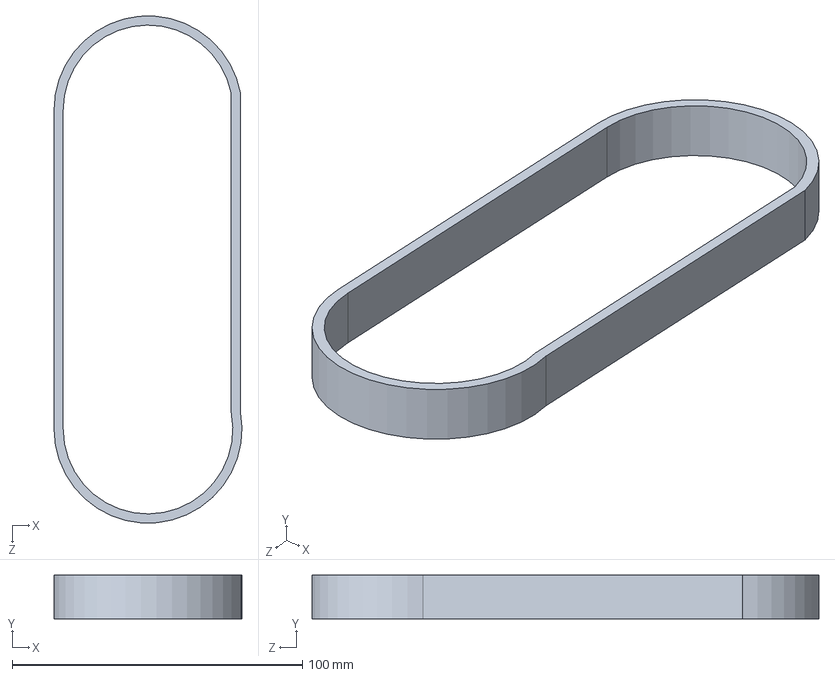
[picture p51: CAD file, 2017-07-01]
Climber Belt 60T (36T pulley).SLDPRT
64.8 x 15.0 x 174.6 mm
