Sabercat-Robotics-4146-FRC/Master-CAD-2017/Gear_v2_pivot angle on back plate.SLDPRT

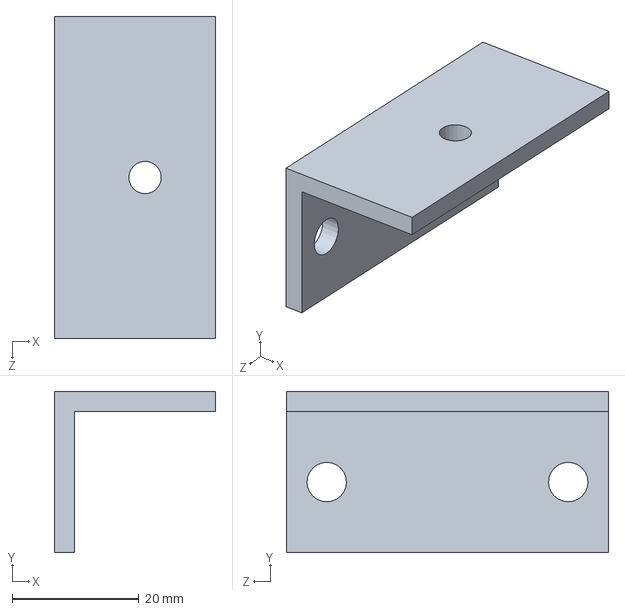
[picture p52: CAD file, 2017-07-01]
Gear_v2_pivot angle on back plate.SLDPRT
25.4 x 25.4 x 50.8 mm
