Sabercat-Robotics-4146-FRC/Master-CAD-2017/Upper Shooter Intake Shaft.SLDPRT

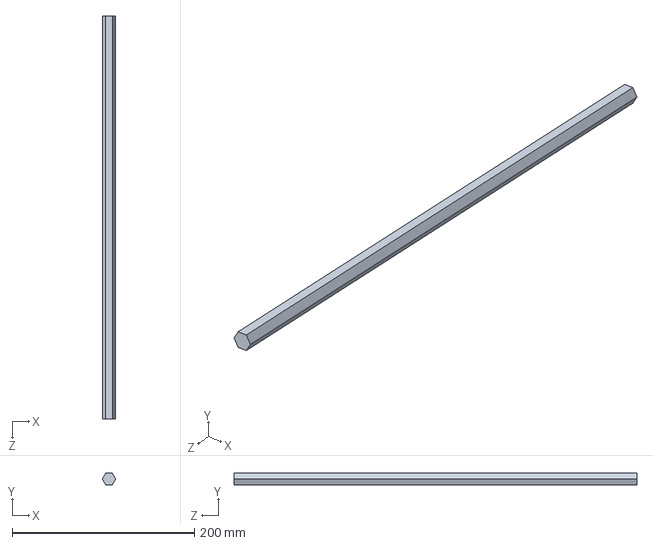
[picture p53: CAD file, 2017-07-01]
Upper Shooter Intake Shaft.SLDPRT
14.7 x 12.7 x 442.0 mm
