Sabercat-Robotics-4146-FRC/Master-CAD-2017/Shooter side plate SHORT.SLDPRT

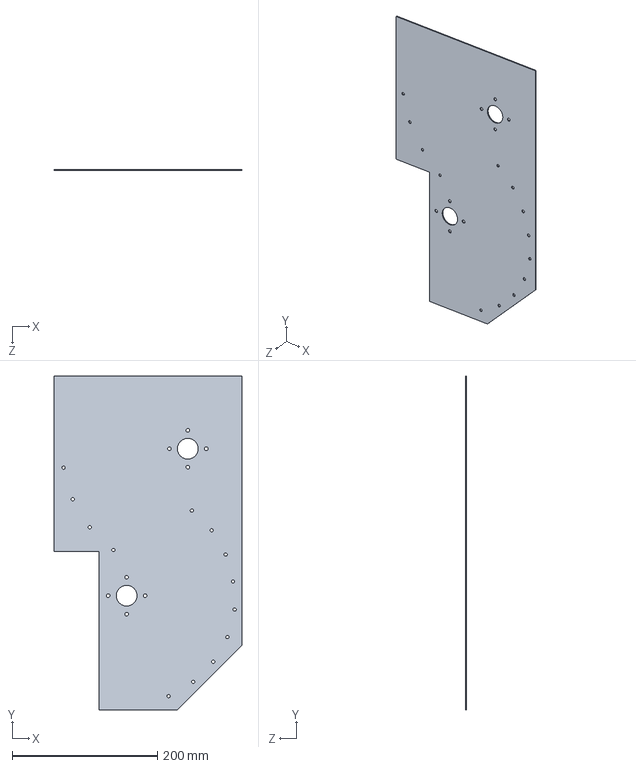
[picture p54: CAD file, 2017-07-01]
Shooter side plate SHORT.SLDPRT
258.8 x 459.7 x 1.59 mm
