Sabercat-Robotics-4146-FRC/Master-CAD-2017/Top to Bottom Rope Guide Bumper Spacer.SLDPRT

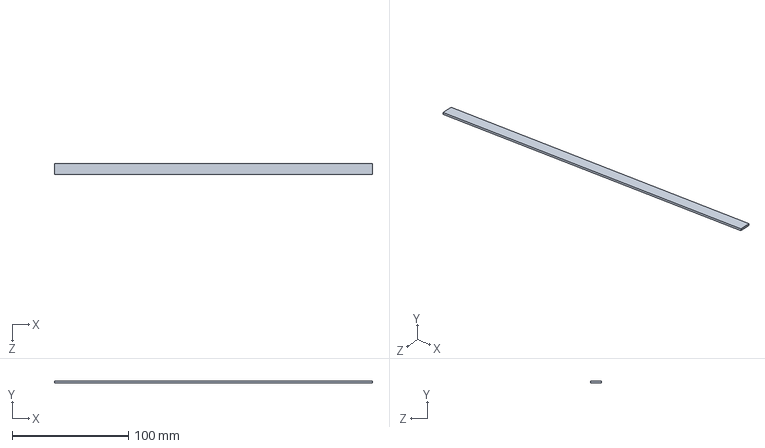
[picture p55: CAD file, 2017-07-01]
Top to Bottom Rope Guide Bumper Spacer.SLDPRT
273.1 x 1.59 x 9.53 mm
