Sabercat-Robotics-4146-FRC/Master-CAD-2017/Gear_v2_motor hub and angle connector.SLDPRT

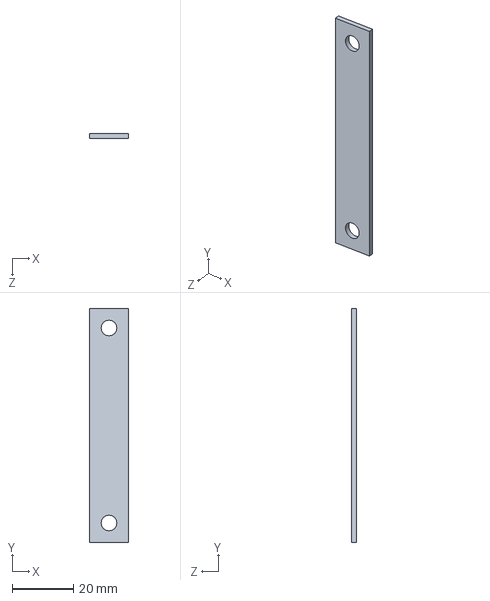
[picture p56: CAD file, 2017-07-01]
Gear_v2_motor hub and angle connector.SLDPRT
12.7 x 76.2 x 1.59 mm
