Sabercat-Robotics-4146-FRC/Master-CAD-2017/Climber Rope Sideplate.SLDPRT

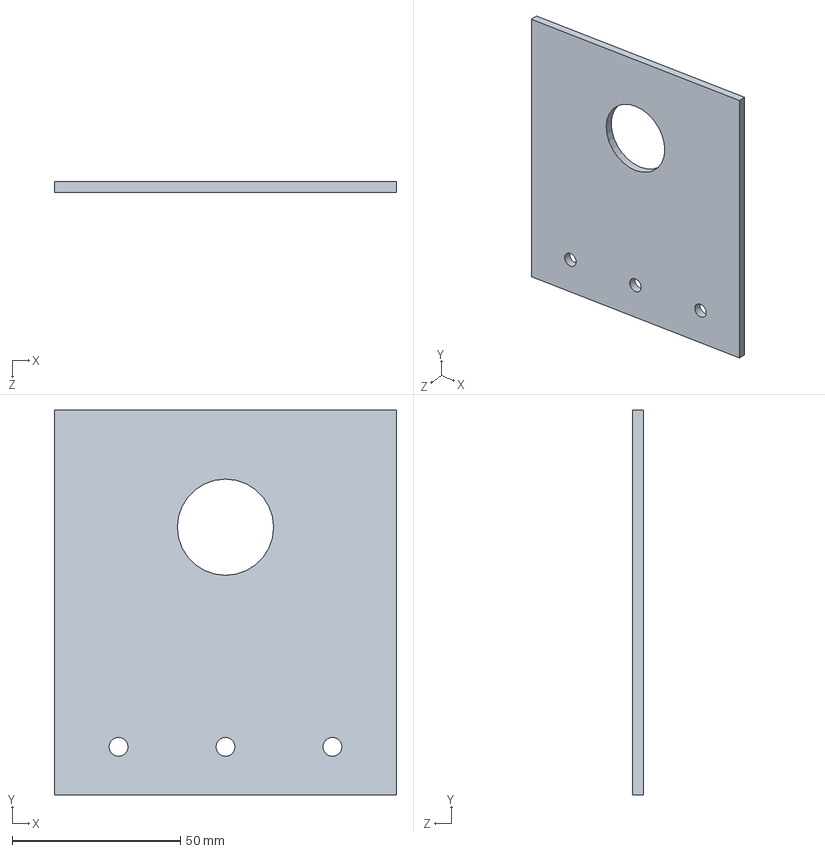
[picture p57: CAD file, 2017-07-01]
Climber Rope Sideplate.SLDPRT
101.6 x 114.3 x 3.17 mm
