Sabercat-Robotics-4146-FRC/Master-CAD-2017/gear support back plate.SLDPRT

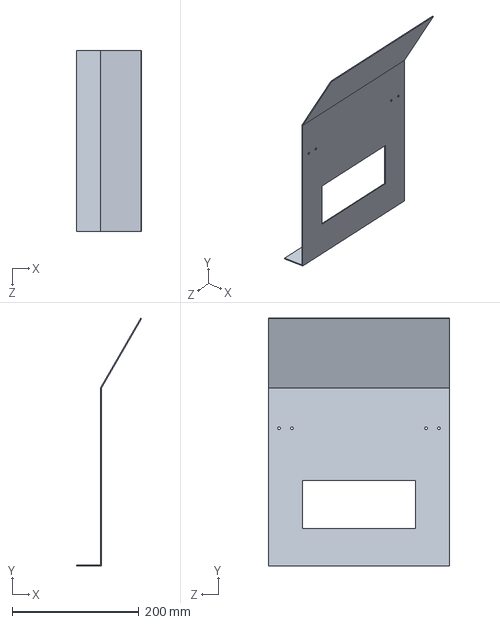
[picture p58: CAD file, 2017-07-01]
gear support back plate.SLDPRT
103.0 x 391.0 x 285.8 mm
