Sabercat-Robotics-4146-FRC/Master-CAD-2017/Base for Vex gear fingers.SLDPRT

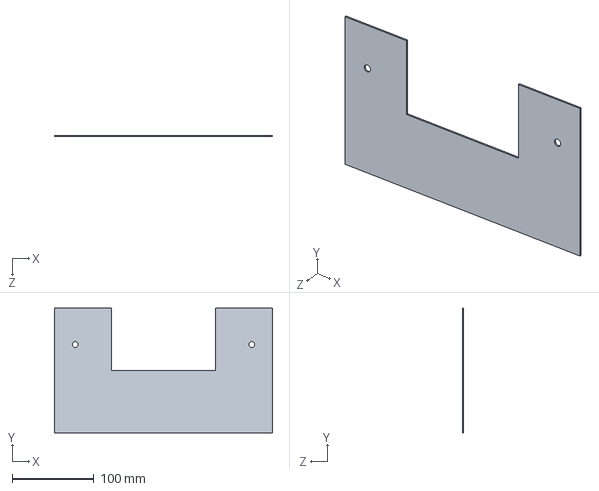
[picture p59: CAD file, 2017-07-01]
Base for Vex gear fingers.SLDPRT
266.7 x 152.4 x 1.60 mm
