Sabercat-Robotics-4146-FRC/Master-CAD-2017/Standoff.SLDPRT

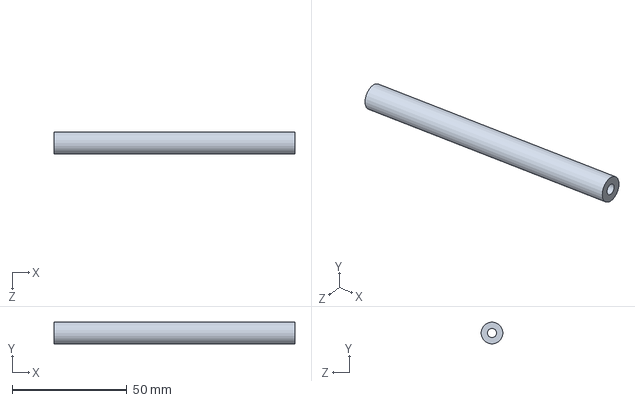
[picture p60: CAD file, 2017-07-01]
Standoff.SLDPRT
105.2 x 9.53 x 9.53 mm
