Sabercat-Robotics-4146-FRC/Master-CAD-2017/Primary Intake Drive Belt.SLDPRT

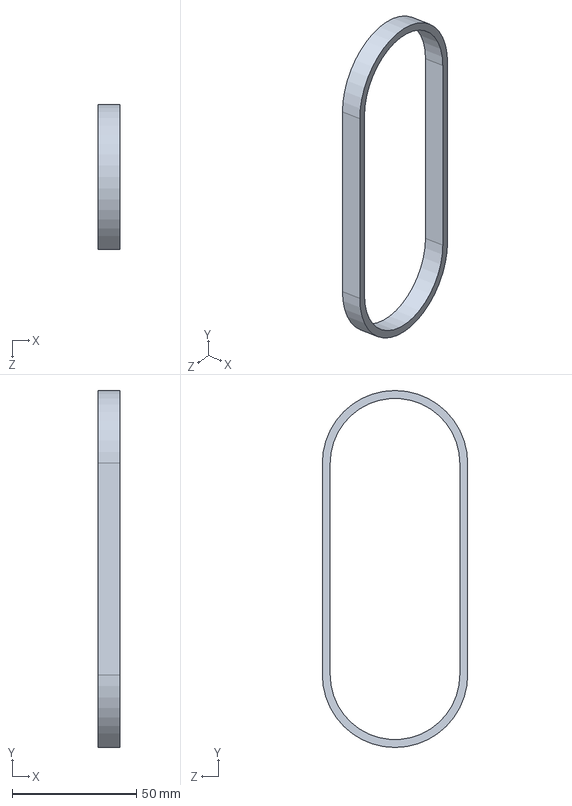
[picture p61: CAD file, 2017-07-01]
Primary Intake Drive Belt.SLDPRT
9.00 x 143.4 x 58.4 mm
