Sabercat-Robotics-4146-FRC/Master-CAD-2017/Side Ball Storage Plate.SLDPRT

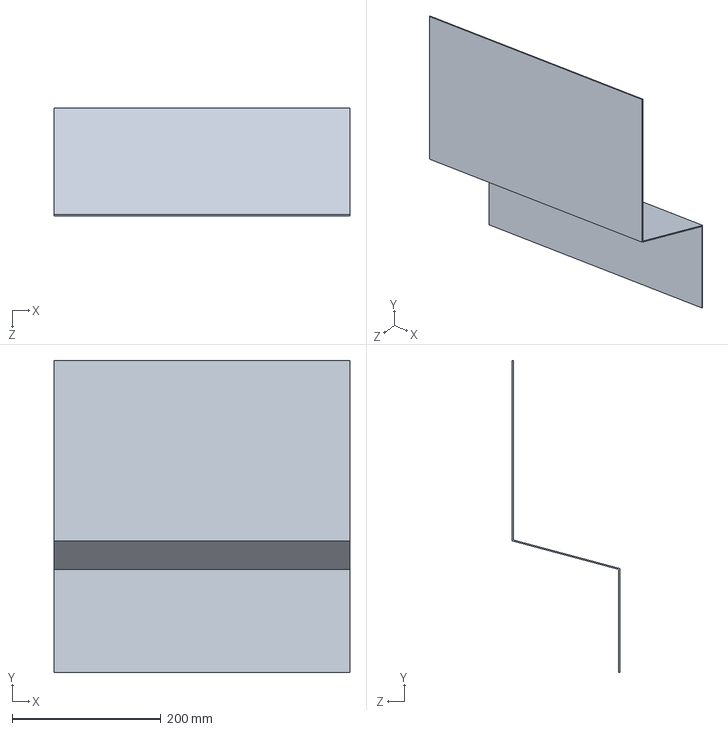
[picture p62: CAD file, 2017-07-01]
Side Ball Storage Plate.SLDPRT
397.3 x 419.1 x 144.6 mm
