Sabercat-Robotics-4146-FRC/Master-CAD-2017/Left Climber Support Bracket.SLDPRT

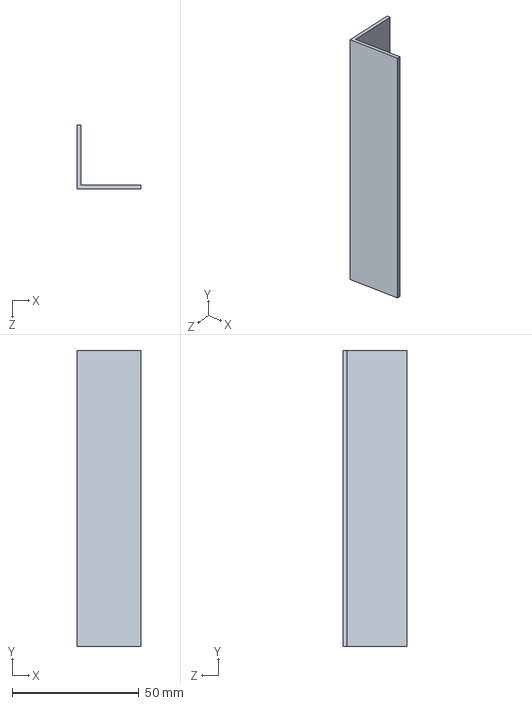
[picture p63: CAD file, 2017-07-01]
Left Climber Support Bracket.SLDPRT
25.4 x 116.8 x 25.4 mm
