Sabercat-Robotics-4146-FRC/Master-CAD-2017/Inner Drive Train Plate Left.SLDPRT

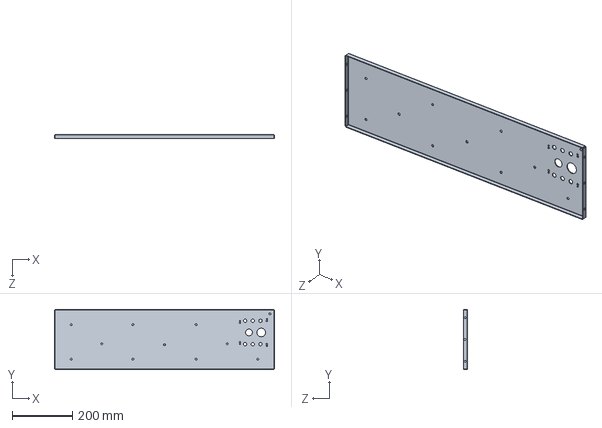
[picture p64: CAD file, 2017-07-01]
Inner Drive Train Plate Left.SLDPRT
728.6 x 200.2 x 12.7 mm
