Sabercat-Robotics-4146-FRC/Master-CAD-2017/Conveyor Tube Belt.SLDPRT

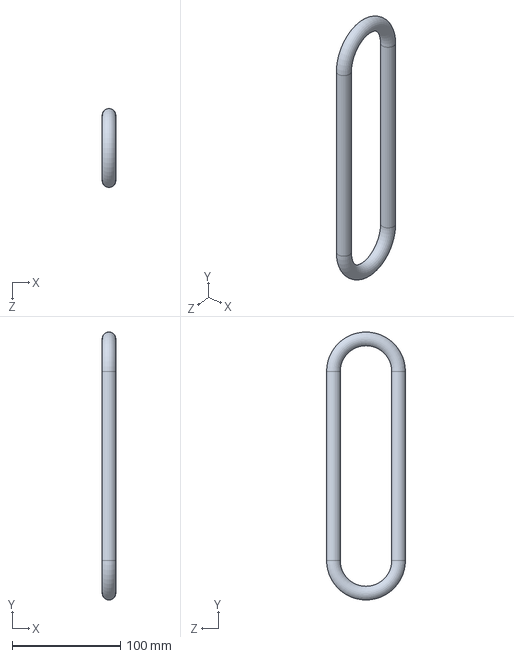
[picture p65: CAD file, 2017-07-01]
Conveyor Tube Belt.SLDPRT
12.7 x 248.0 x 73.0 mm
