Sabercat-Robotics-4146-FRC/Master-CAD-2017/Gear_v2_Ramp Support.SLDPRT

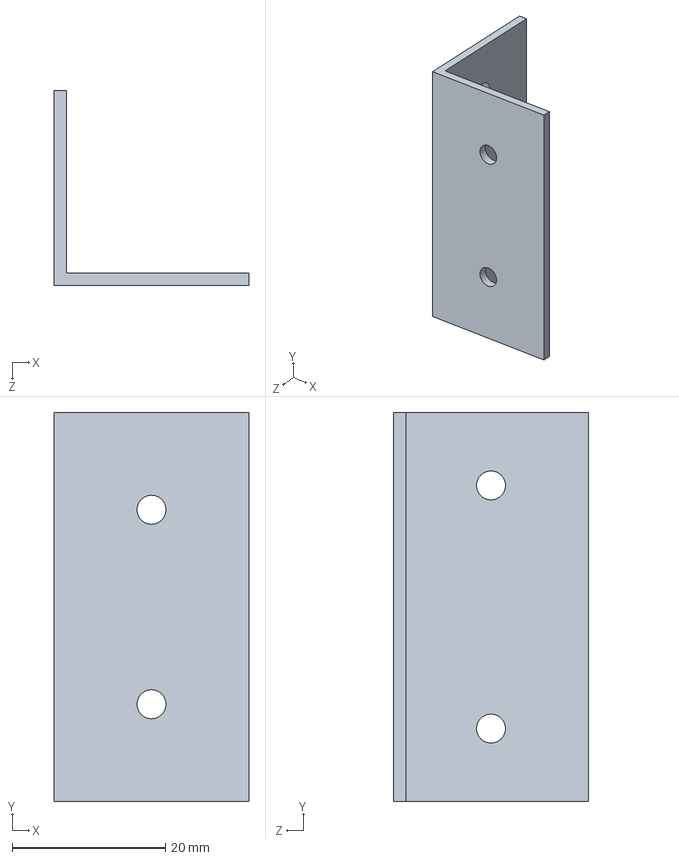
[picture p66: CAD file, 2017-07-01]
Gear_v2_Ramp Support.SLDPRT
25.4 x 50.8 x 25.4 mm
