Sabercat-Robotics-4146-FRC/Master-CAD-2017/Angle Piece for Climber Side Plate.SLDPRT

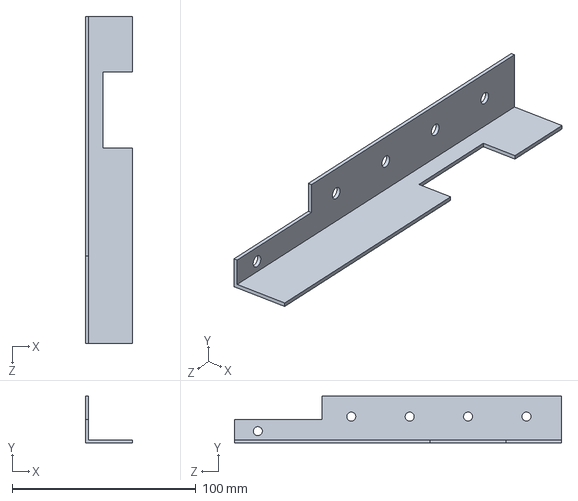
[picture p67: CAD file, 2017-07-01]
Angle Piece for Climber Side Plate.SLDPRT
25.4 x 25.4 x 177.8 mm
