Sabercat-Robotics-4146-FRC/Master-CAD-2017/Rear Bumper Support.SLDPRT

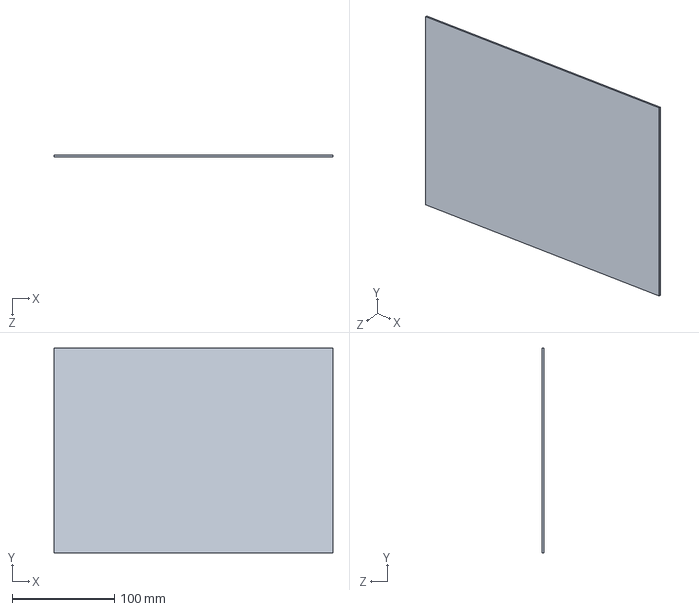
[picture p68: CAD file, 2017-07-01]
Rear Bumper Support.SLDPRT
273.1 x 200.2 x 1.60 mm
