Sabercat-Robotics-4146-FRC/Master-CAD-2017/Outer Pulley.sldprt

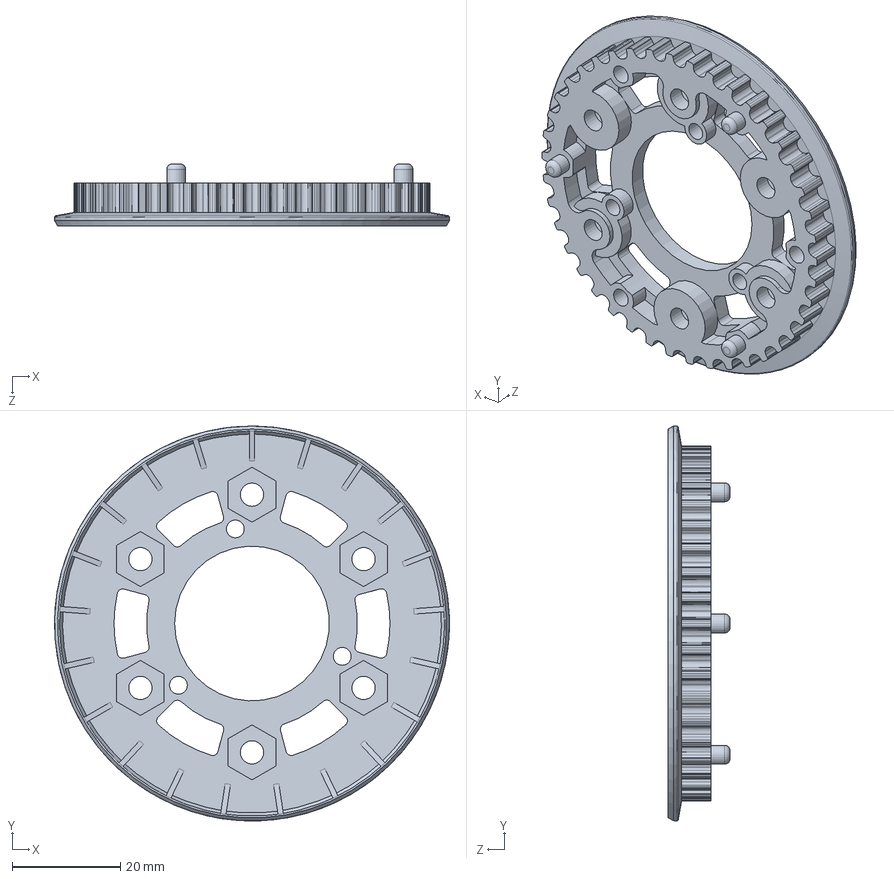
[picture p69: CAD file, 2017-07-01]
Outer Pulley.sldprt
73.0 x 73.0 x 11.5 mm
