Sabercat-Robotics-4146-FRC/Master-CAD-2017/Vex Shaft.SLDPRT

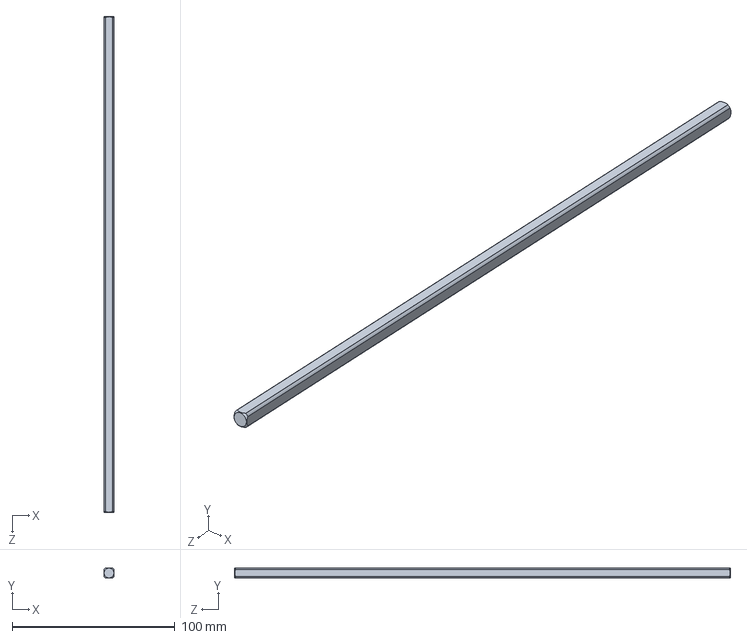
[picture p70: CAD file, 2017-07-01]
Vex Shaft.SLDPRT
6.35 x 6.35 x 304.8 mm
