Sabercat-Robotics-4146-FRC/Master-CAD-2017/Front Drive Train Plate.SLDPRT

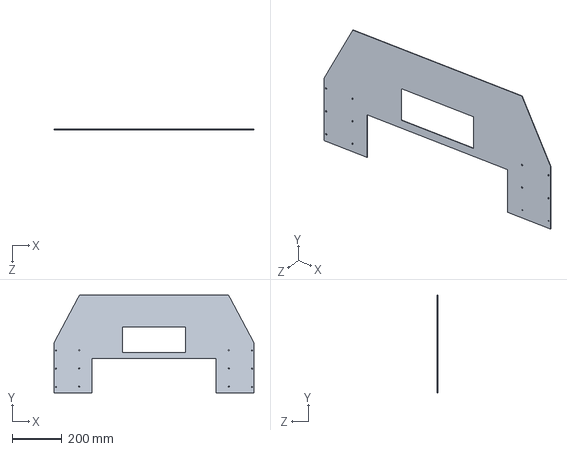
[picture p71: CAD file, 2017-07-01]
Front Drive Train Plate.SLDPRT
800.1 x 390.9 x 1.60 mm
