Sabercat-Robotics-4146-FRC/Master-CAD-2017/Rear Intake Brace Angle.SLDPRT

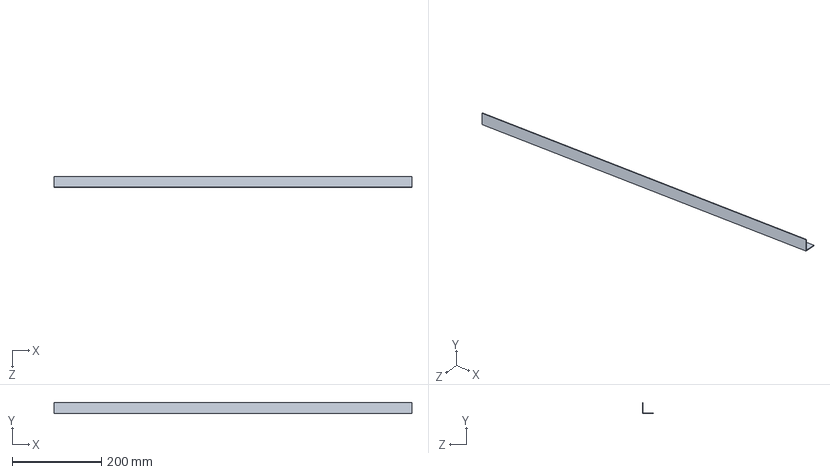
[picture p72: CAD file, 2017-07-01]
Rear Intake Brace Angle.SLDPRT
800.1 x 25.4 x 25.4 mm
