Sabercat-Robotics-4146-FRC/Master-CAD-2017/Right Top Bumper Support.SLDPRT

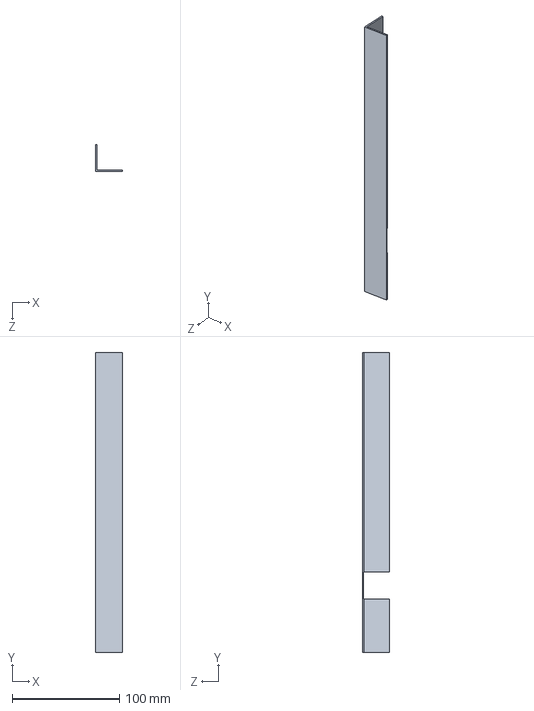
[picture p73: CAD file, 2017-07-01]
Right Top Bumper Support.SLDPRT
25.4 x 279.4 x 25.4 mm
