Sabercat-Robotics-4146-FRC/Master-CAD-2017/Vex Gear 36T High Strength.SLDPRT

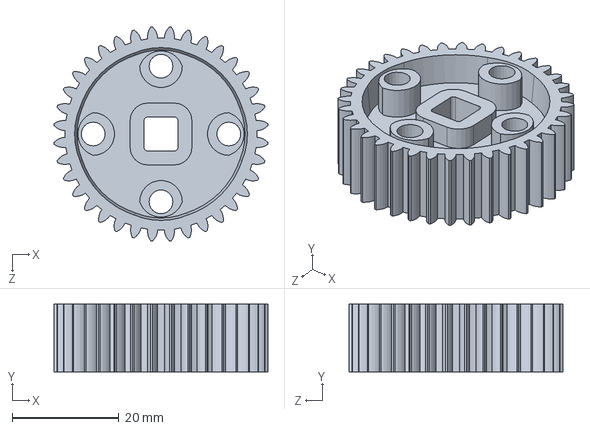
[picture p74: CAD file, 2017-07-01]
Vex Gear 36T High Strength.SLDPRT
40.1 x 12.7 x 40.1 mm
