Sabercat-Robotics-4146-FRC/Master-CAD-2017/Bottom Back Plate for Support.SLDPRT

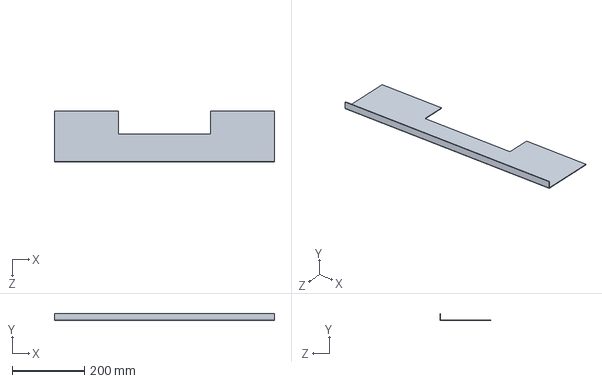
[picture p75: CAD file, 2017-07-01]
Bottom Back Plate for Support.SLDPRT
608.8 x 19.0 x 142.0 mm
