Sabercat-Robotics-4146-FRC/Master-CAD-2017/Intake Box Front Rail.SLDPRT

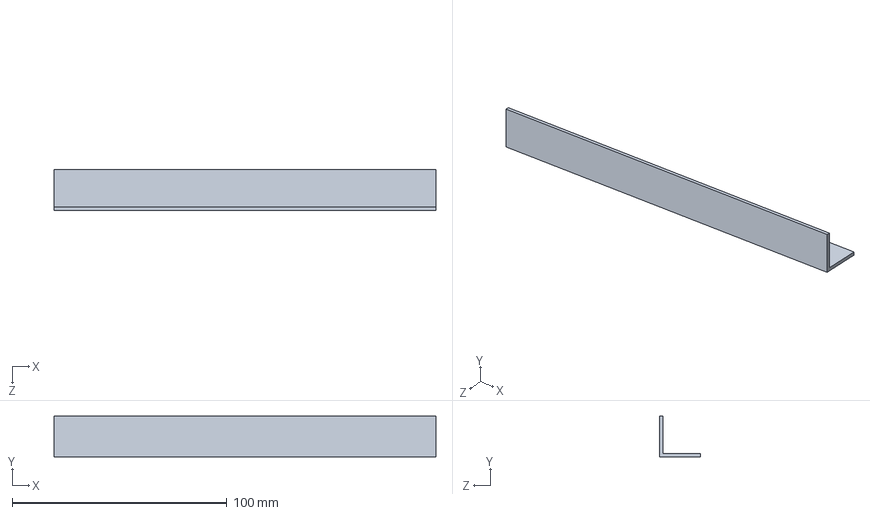
[picture p76: CAD file, 2017-07-01]
Intake Box Front Rail.SLDPRT
177.8 x 19.1 x 19.1 mm
