Sabercat-Robotics-4146-FRC/Master-CAD-2017/NS_01_40_200_1rail.SLDPRT

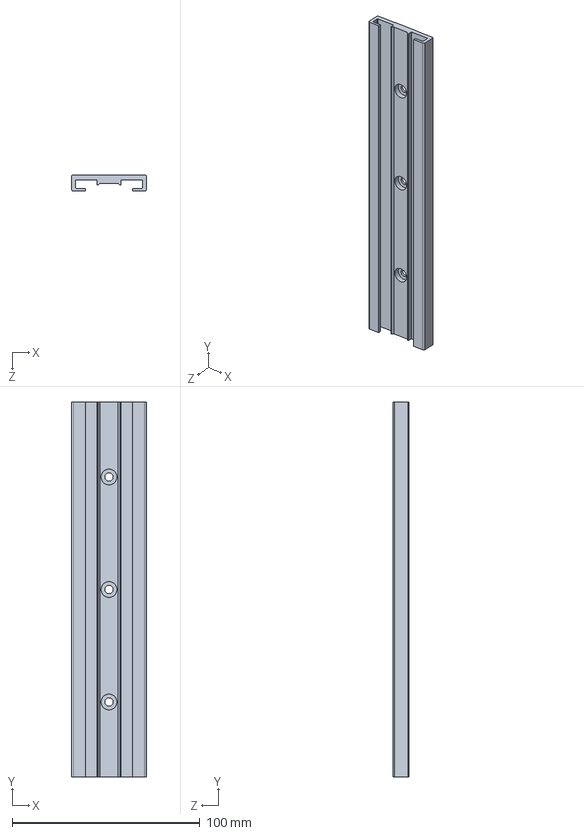
[picture p77: CAD file, 2017-07-01]
NS_01_40_200_1rail.SLDPRT
40.0 x 200.0 x 8.70 mm
