Sabercat-Robotics-4146-FRC/Master-CAD-2017/-25in rear Bumper SpacerSLDPRT.SLDPRT

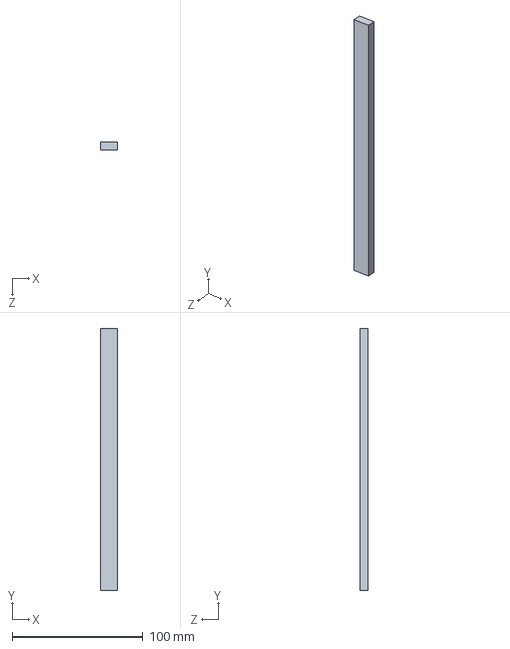
[picture p78: CAD file, 2017-07-01]
-25in rear Bumper SpacerSLDPRT.SLDPRT
12.7 x 200.2 x 6.35 mm
