Sabercat-Robotics-4146-FRC/Master-CAD-2017/Climber Rope Winder.SLDPRT

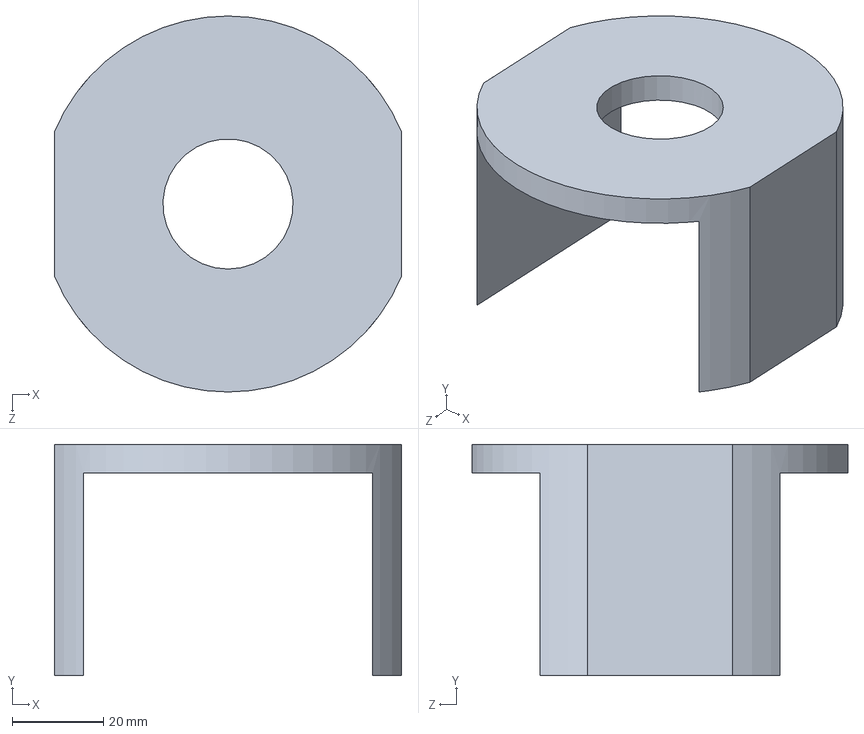
[picture p79: CAD file, 2017-07-01]
Climber Rope Winder.SLDPRT
76.2 x 50.8 x 82.6 mm
