Sabercat-Robotics-4146-FRC/Master-CAD-2017/217-3229.SLDPRT

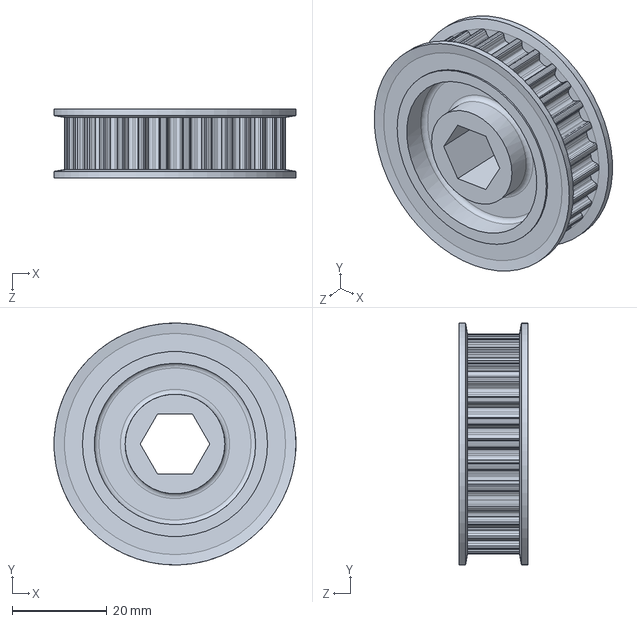
[picture p80: CAD file, 2017-07-01]
217-3229.SLDPRT
51.0 x 51.0 x 14.5 mm
