Sabercat-Robotics-4146-FRC/Master-CAD-2017/Slider Offset Block.SLDPRT

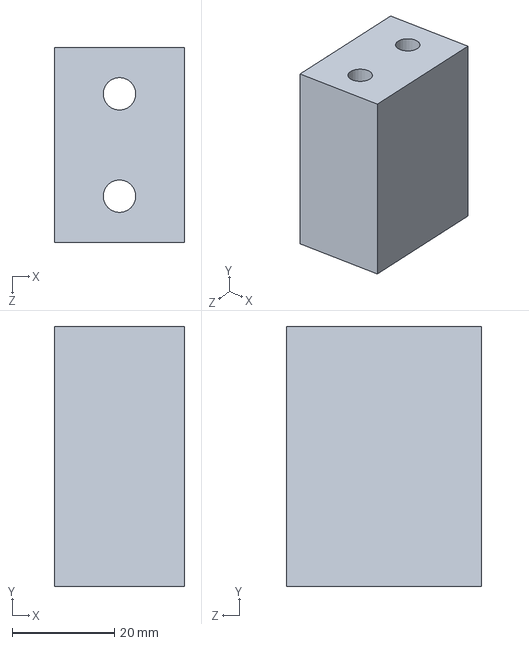
[picture p81: CAD file, 2017-07-01]
Slider Offset Block.SLDPRT
25.4 x 50.8 x 38.1 mm
