Sabercat-Robotics-4146-FRC/Master-CAD-2017/Side of U Climber Rope Guide Side.SLDPRT

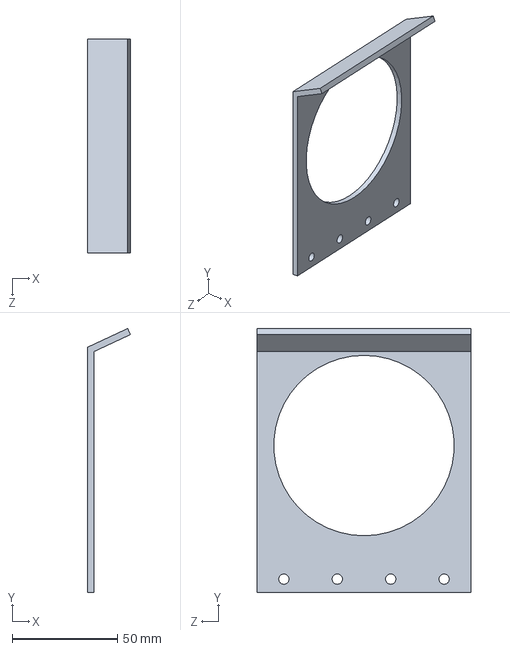
[picture p82: CAD file, 2017-07-01]
Side of U Climber Rope Guide Side.SLDPRT
20.4 x 125.5 x 101.6 mm
