Sabercat-Robotics-4146-FRC/Master-CAD-2017/Fuel.SLDPRT

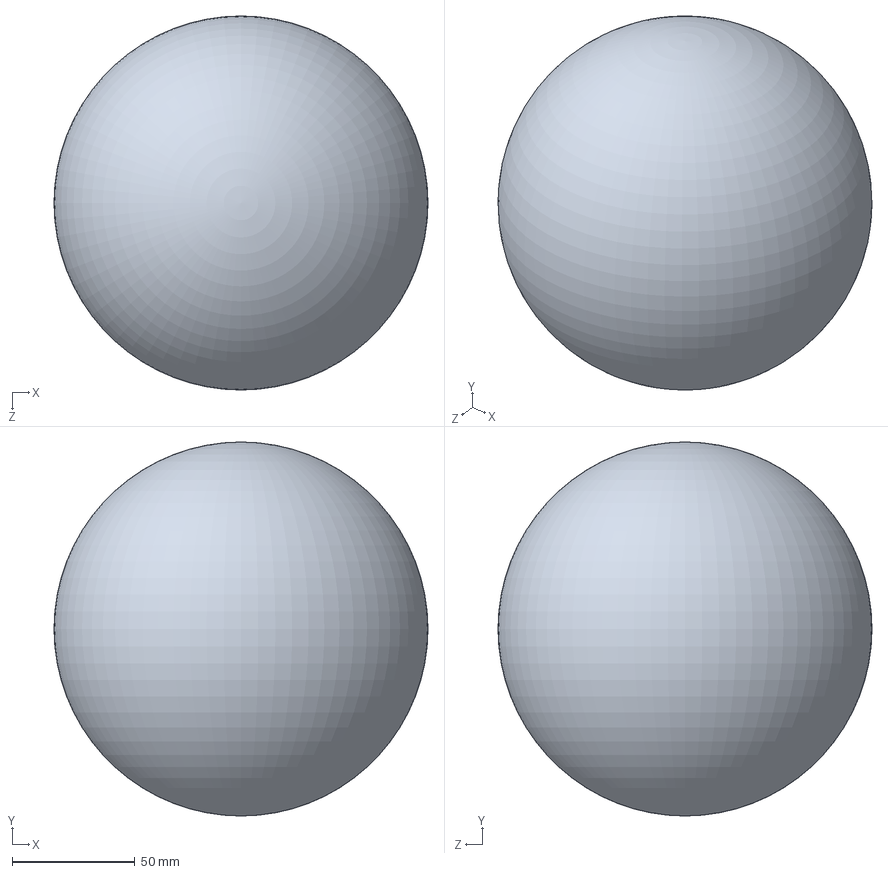
[picture p83: CAD file, 2017-07-01]
Fuel.SLDPRT
152.4 x 152.4 x 152.4 mm
