Sabercat-Robotics-4146-FRC/Master-CAD-2017/NS_01_40_200_1rail Climber.SLDPRT

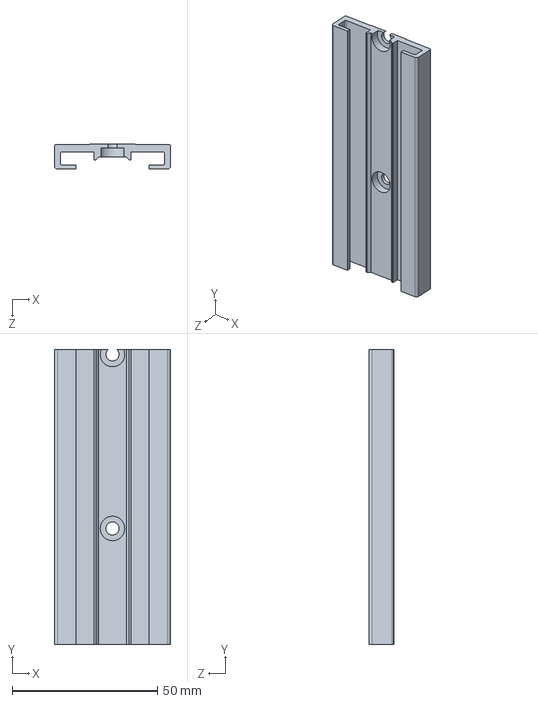
[picture p84: CAD file, 2017-07-01]
NS_01_40_200_1rail Climber.SLDPRT
40.0 x 101.7 x 8.70 mm
