Sabercat-Robotics-4146-FRC/Master-CAD-2017/3-4 side to shooter rear support.SLDPRT

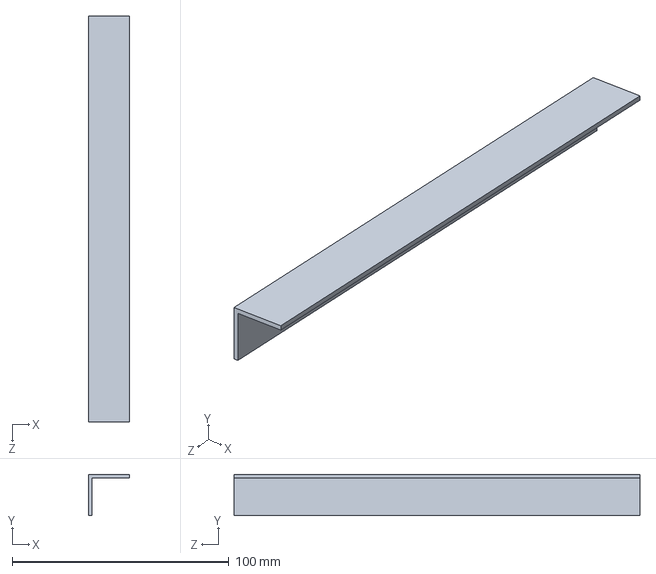
[picture p85: CAD file, 2017-07-01]
3-4 side to shooter rear support.SLDPRT
19.1 x 19.1 x 187.3 mm
