Sabercat-Robotics-4146-FRC/Master-CAD-2017/Gear_v2_linkage rod end.SLDPRT

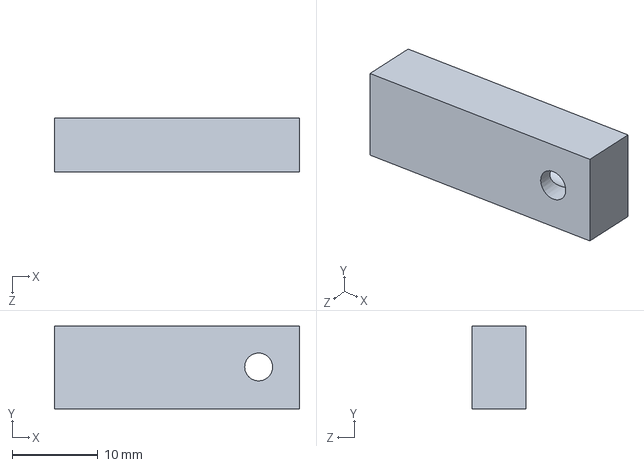
[picture p86: CAD file, 2017-07-01]
Gear_v2_linkage rod end.SLDPRT
28.6 x 9.65 x 6.35 mm
