Sabercat-Robotics-4146-FRC/Master-CAD-2017/Radio Base.SLDPRT

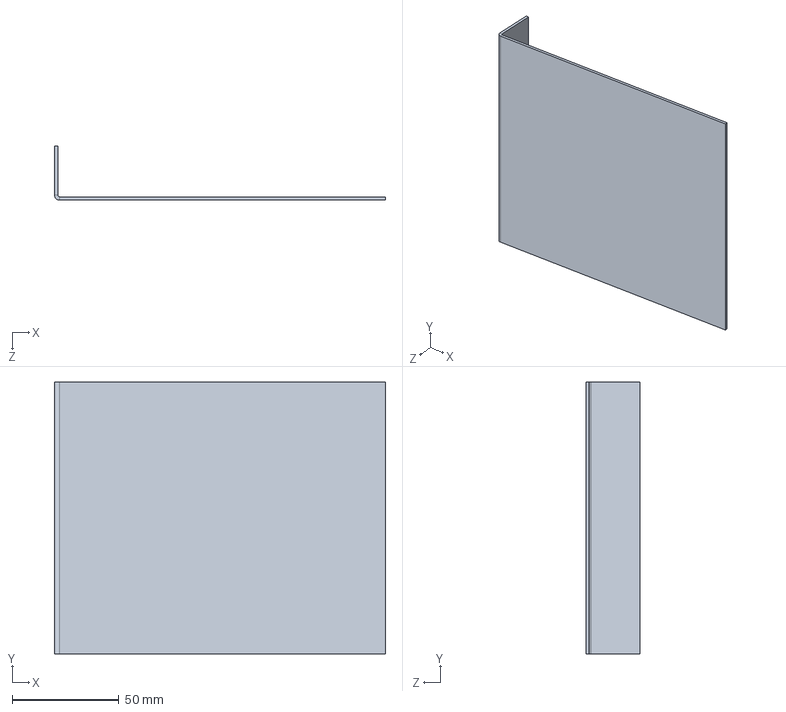
[picture p87: CAD file, 2017-07-01]
Radio Base.SLDPRT
154.7 x 127.0 x 25.4 mm
