Sabercat-Robotics-4146-FRC/Master-CAD-2017/Gear_v2_Left Ramp.SLDPRT

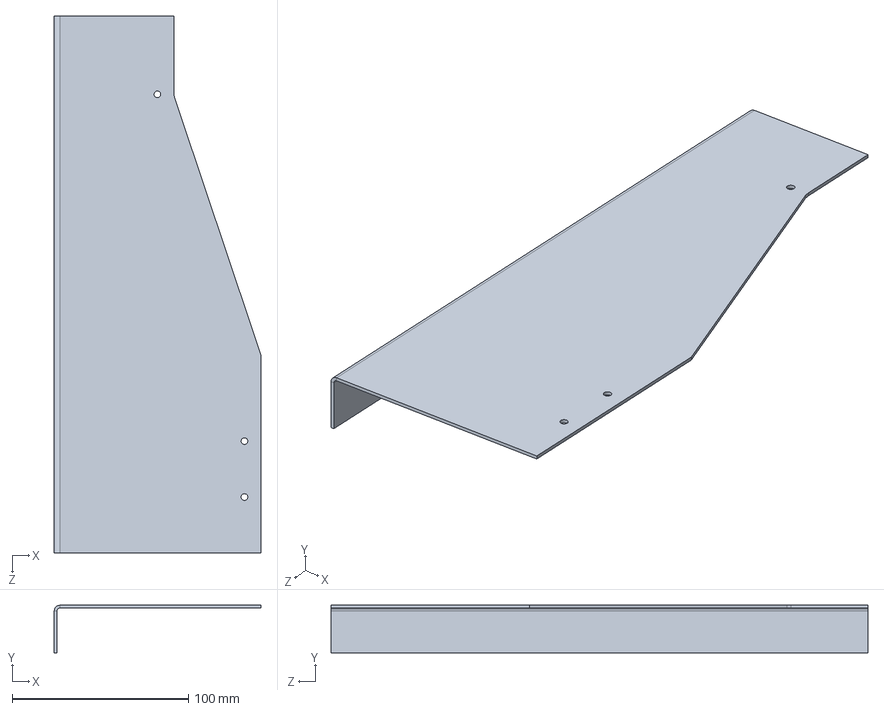
[picture p88: CAD file, 2017-07-01]
Gear_v2_Left Ramp.SLDPRT
117.2 x 27.0 x 304.8 mm
