Sabercat-Robotics-4146-FRC/Master-CAD-2017/Climber Guide Baseplate.SLDPRT

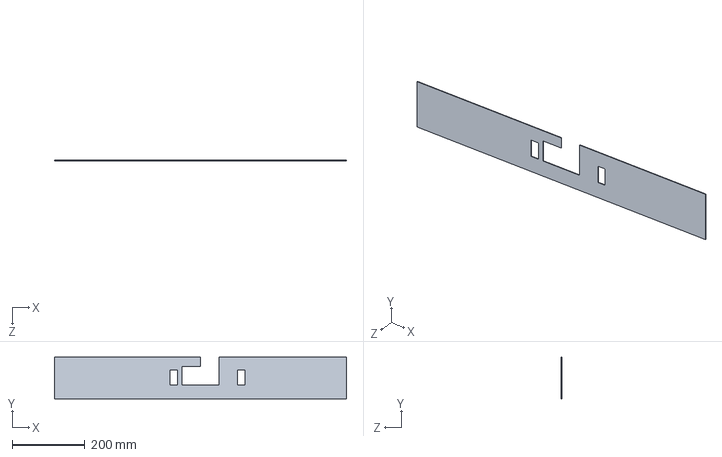
[picture p89: CAD file, 2017-07-01]
Climber Guide Baseplate.SLDPRT
800.1 x 114.3 x 1.60 mm
