Sabercat-Robotics-4146-FRC/Master-CAD-2017/Gear_v2_Mock door hinge leaf plus pin.SLDPRT

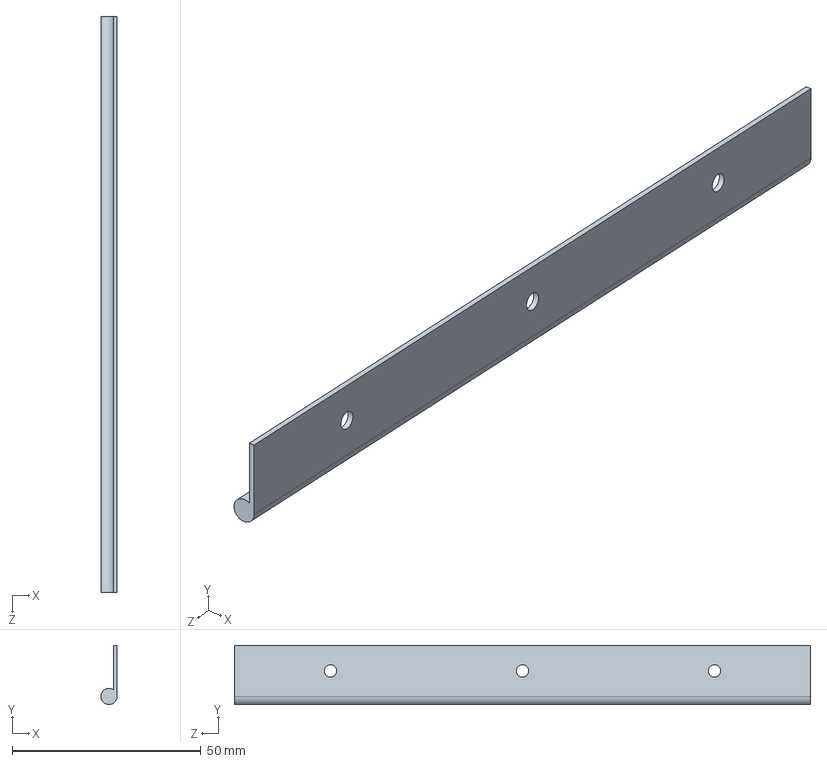
[picture p90: CAD file, 2017-07-01]
Gear_v2_Mock door hinge leaf plus pin.SLDPRT
4.30 x 15.6 x 152.4 mm
