Sabercat-Robotics-4146-FRC/Master-CAD-2017/Gear_v2_Polycarb gear rail.SLDPRT

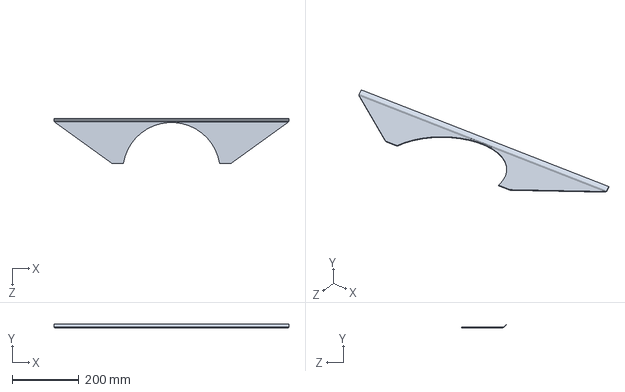
[picture p91: CAD file, 2017-07-01]
Gear_v2_Polycarb gear rail.SLDPRT
704.8 x 10.6 x 136.4 mm
