Sabercat-Robotics-4146-FRC/Master-CAD-2017/Piano Hinge.SLDPRT

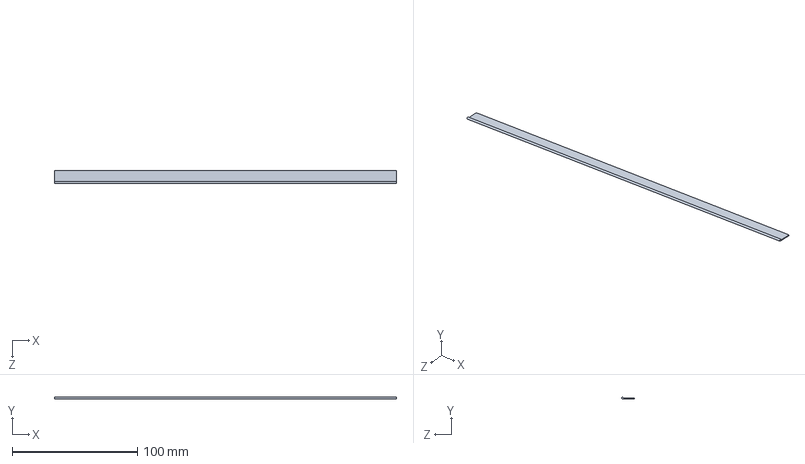
[picture p92: CAD file, 2017-07-01]
Piano Hinge.SLDPRT
273.1 x 1.59 x 10.4 mm
