Sabercat-Robotics-4146-FRC/Master-CAD-2017/Right Climber Support Bracket.SLDPRT

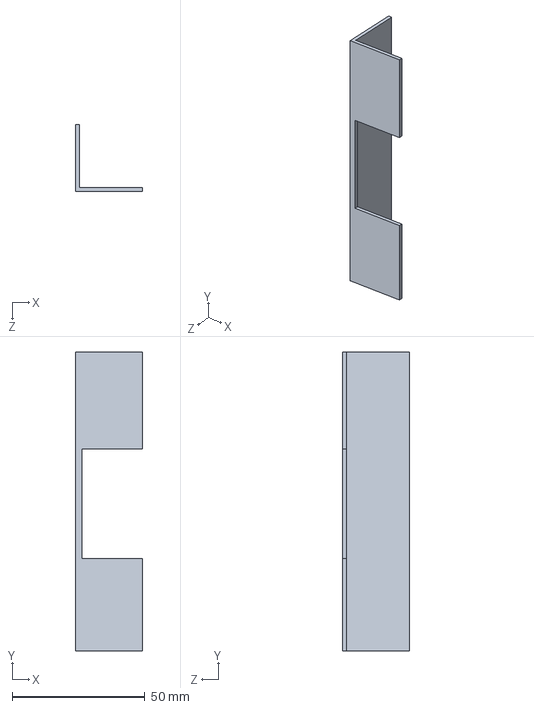
[picture p93: CAD file, 2017-07-01]
Right Climber Support Bracket.SLDPRT
25.4 x 112.7 x 25.4 mm
