Sabercat-Robotics-4146-FRC/Master-CAD-2017/12V_Battery 2017.SLDPRT

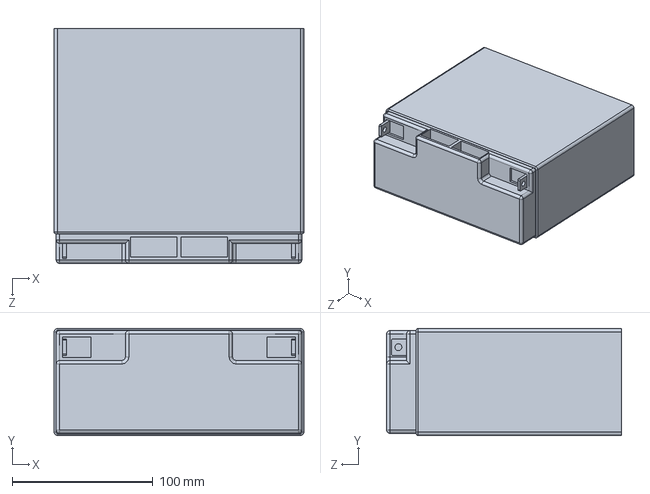
[picture p94: CAD file, 2017-07-01]
12V_Battery 2017.SLDPRT
177.8 x 76.2 x 167.1 mm
