Sabercat-Robotics-4146-FRC/Master-CAD-2017/Backing Plate.SLDPRT

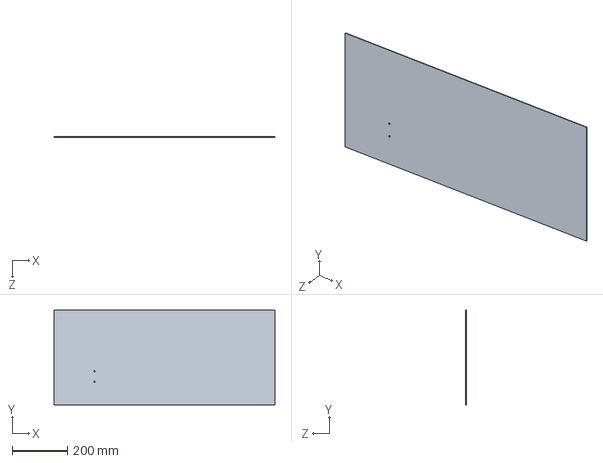
[picture p95: CAD file, 2017-07-01]
Backing Plate.SLDPRT
800.4 x 342.9 x 1.59 mm
