Sabercat-Robotics-4146-FRC/Master-CAD-2017/Bottom of U Climber Rope guide.SLDPRT

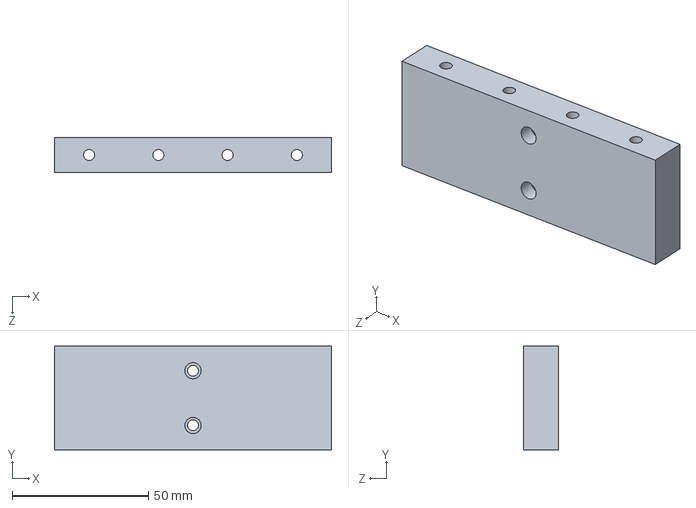
[picture p96: CAD file, 2017-07-01]
Bottom of U Climber Rope guide.SLDPRT
101.6 x 38.1 x 12.7 mm
