Sabercat-Robotics-4146-FRC/Master-CAD-2017/Gear_v2 right door true.SLDPRT

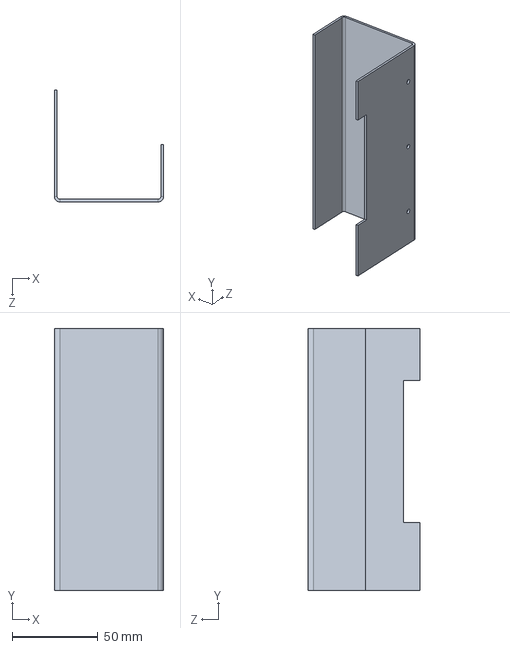
[picture p97: CAD file, 2017-07-01]
Gear_v2 right door true.SLDPRT
63.5 x 152.4 x 65.1 mm
