Sabercat-Robotics-4146-FRC/Master-CAD-2017/217-3231.SLDPRT

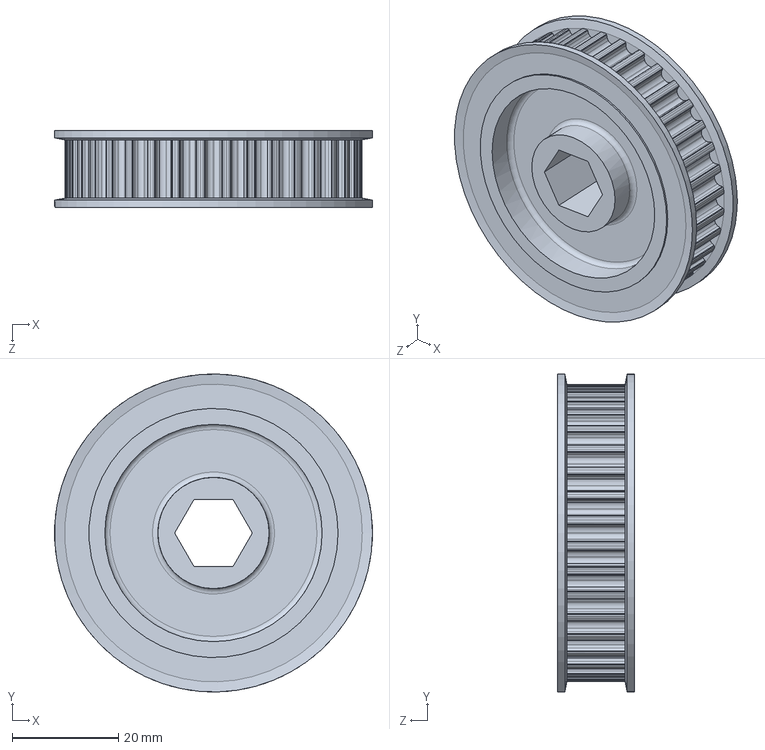
[picture p98: CAD file, 2017-07-01]
217-3231.SLDPRT
60.0 x 60.0 x 14.5 mm
