Sabercat-Robotics-4146-FRC/Master-CAD-2017/Shooter angle top bracket.SLDPRT

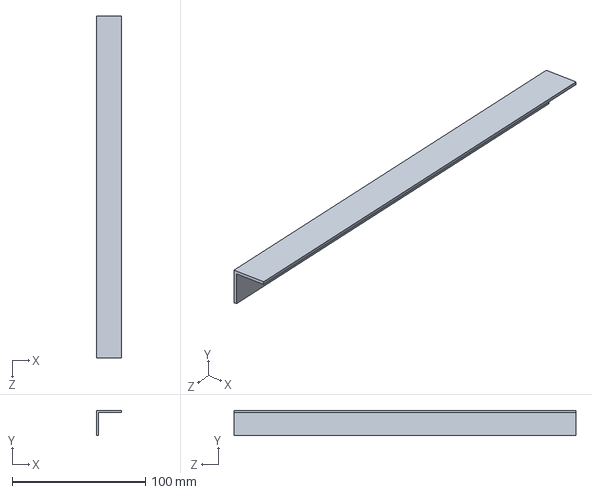
[picture p99: CAD file, 2017-07-01]
Shooter angle top bracket.SLDPRT
19.1 x 19.1 x 256.5 mm
