Sabercat-Robotics-4146-FRC/Master-CAD-2017/Banebots T40P 2-875.SLDPRT

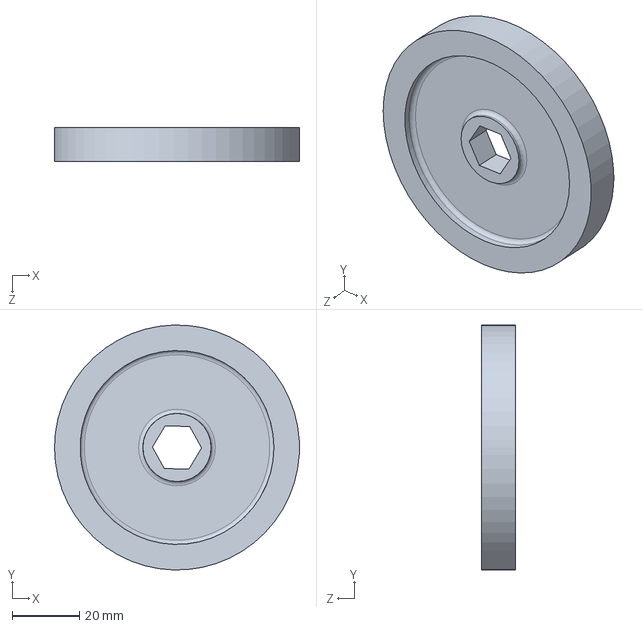
[picture p100: CAD file, 2017-07-01]
Banebots T40P 2-875.SLDPRT
73.0 x 73.0 x 10.2 mm
