Sabercat-Robotics-4146-FRC/Master-CAD-2017/Fake Power Dist Panel.SLDPRT

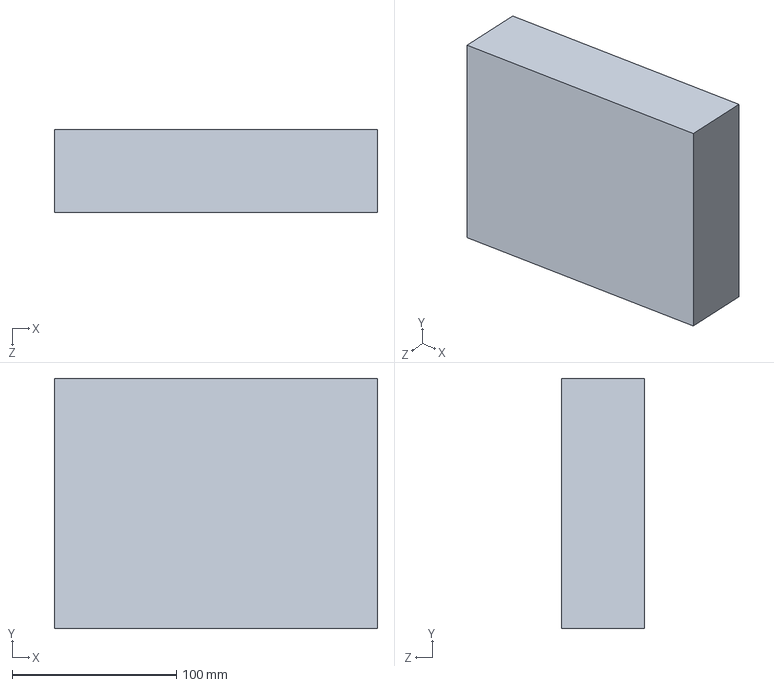
[picture p101: CAD file, 2017-07-01]
Fake Power Dist Panel.SLDPRT
196.9 x 152.4 x 50.8 mm
