Sabercat-Robotics-4146-FRC/Master-CAD-2017/VEXpro_VersaPlanetary_with_RS775.SLDPRT

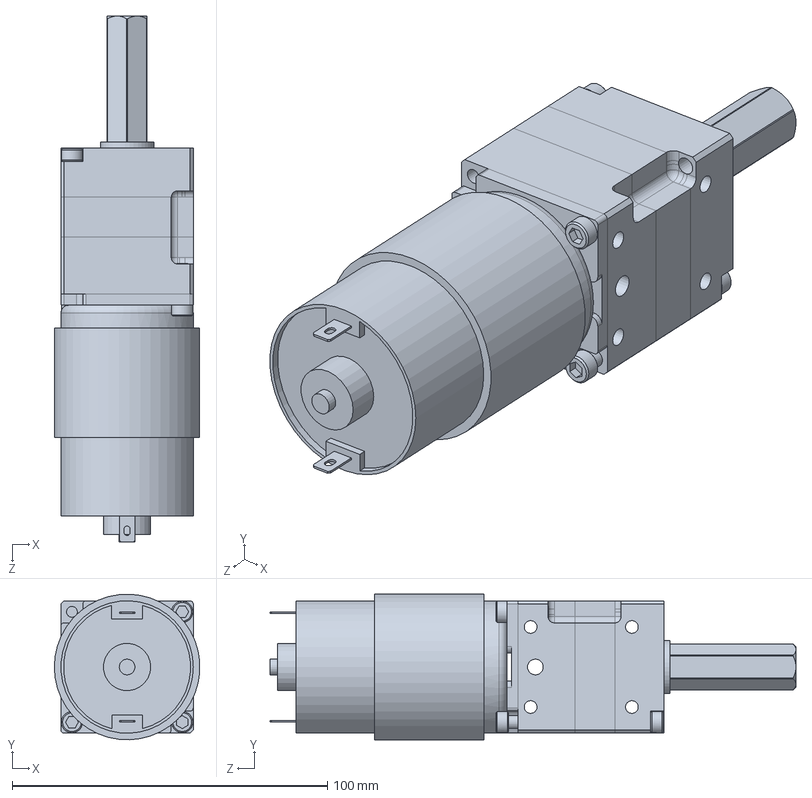
[picture p102: CAD file, 2017-07-01]
VEXpro_VersaPlanetary_with_RS775.SLDPRT
46.1 x 46.2 x 166.9 mm
