Sabercat-Robotics-4146-FRC/Master-CAD-2017/Fake Servo Tactic TSX45.SLDPRT

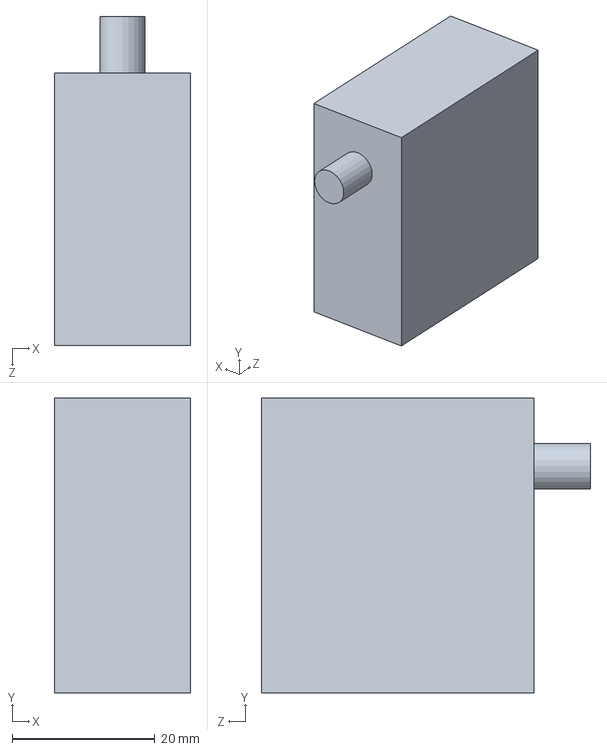
[picture p103: CAD file, 2017-07-01]
Fake Servo Tactic TSX45.SLDPRT
19.1 x 41.3 x 46.0 mm
