Sabercat-Robotics-4146-FRC/Master-CAD-2017/Servo base block.SLDPRT

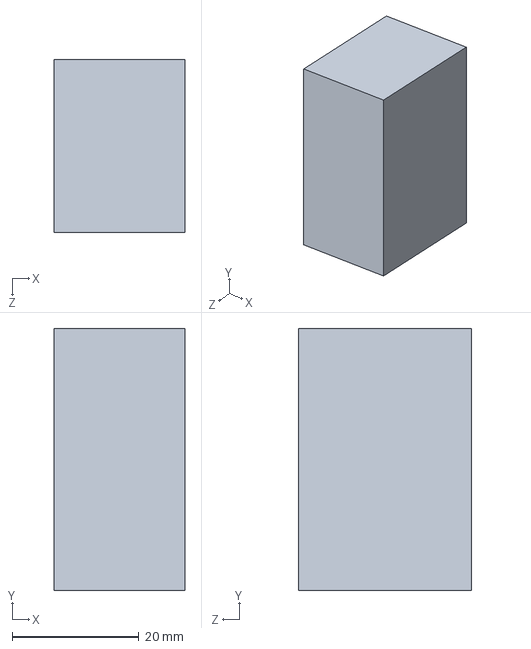
[picture p104: CAD file, 2017-07-01]
Servo base block.SLDPRT
20.6 x 41.3 x 27.3 mm
