Sabercat-Robotics-4146-FRC/Master-CAD-2017/Gear_v2_linkage Bellcrank.SLDPRT

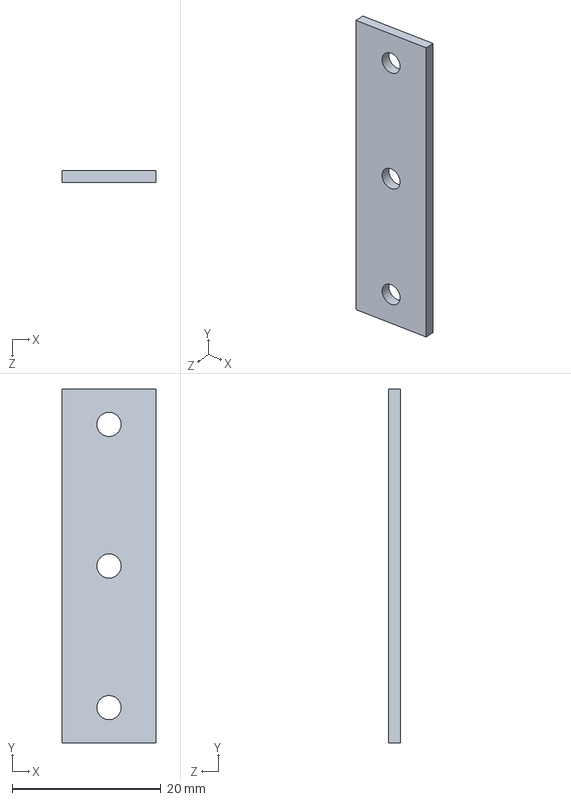
[picture p105: CAD file, 2017-07-01]
Gear_v2_linkage Bellcrank.SLDPRT
12.7 x 47.6 x 1.59 mm
