Sabercat-Robotics-4146-FRC/Master-CAD-2017/Gear_v2_Bracket 1-2 inch.SLDPRT

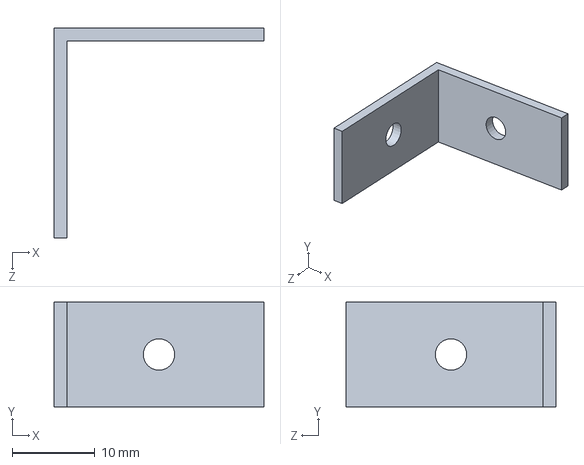
[picture p106: CAD file, 2017-07-01]
Gear_v2_Bracket 1-2 inch.SLDPRT
25.4 x 12.7 x 25.4 mm
