Sabercat-Robotics-4146-FRC/Master-CAD-2017/Gear_v2_servo rotating plate.SLDPRT

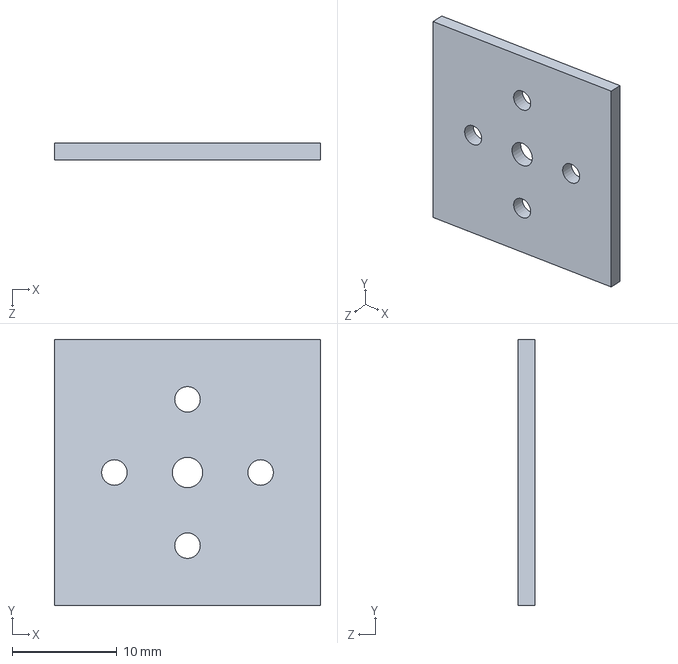
[picture p107: CAD file, 2017-07-01]
Gear_v2_servo rotating plate.SLDPRT
25.4 x 25.4 x 1.59 mm
