Sabercat-Robotics-4146-FRC/Master-CAD-2017/Climber Gearbox for CIM .SLDPRT

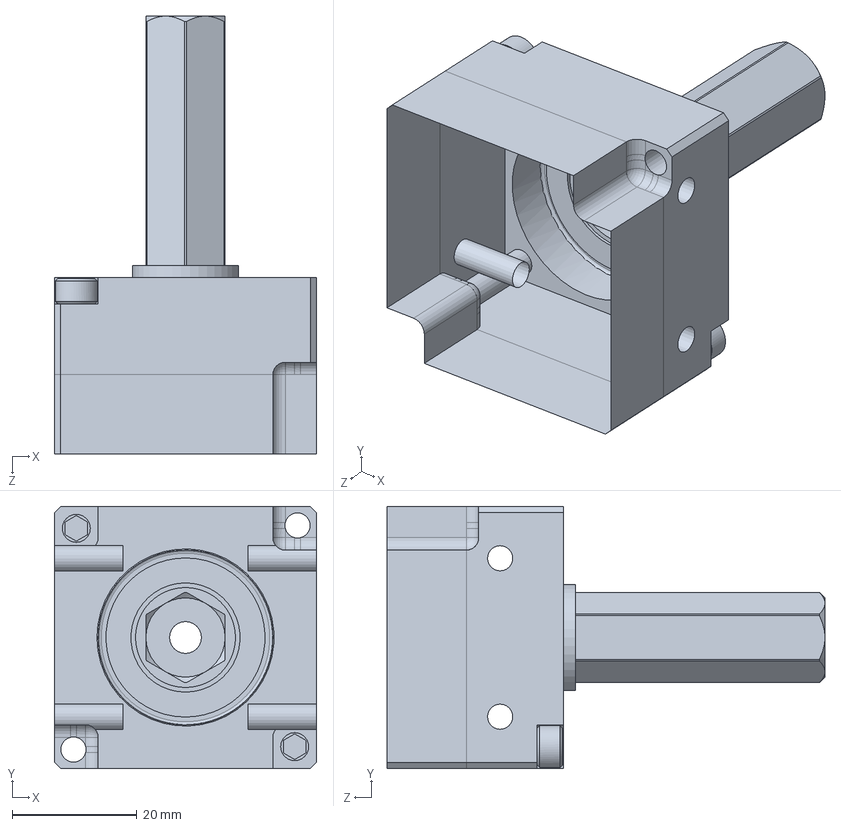
[picture p108: CAD file, 2017-07-01]
Climber Gearbox for CIM .SLDPRT
42.0 x 42.0 x 70.2 mm
