Sabercat-Robotics-4146-FRC/Master-CAD-2017/3-4 brace for top intake.SLDPRT

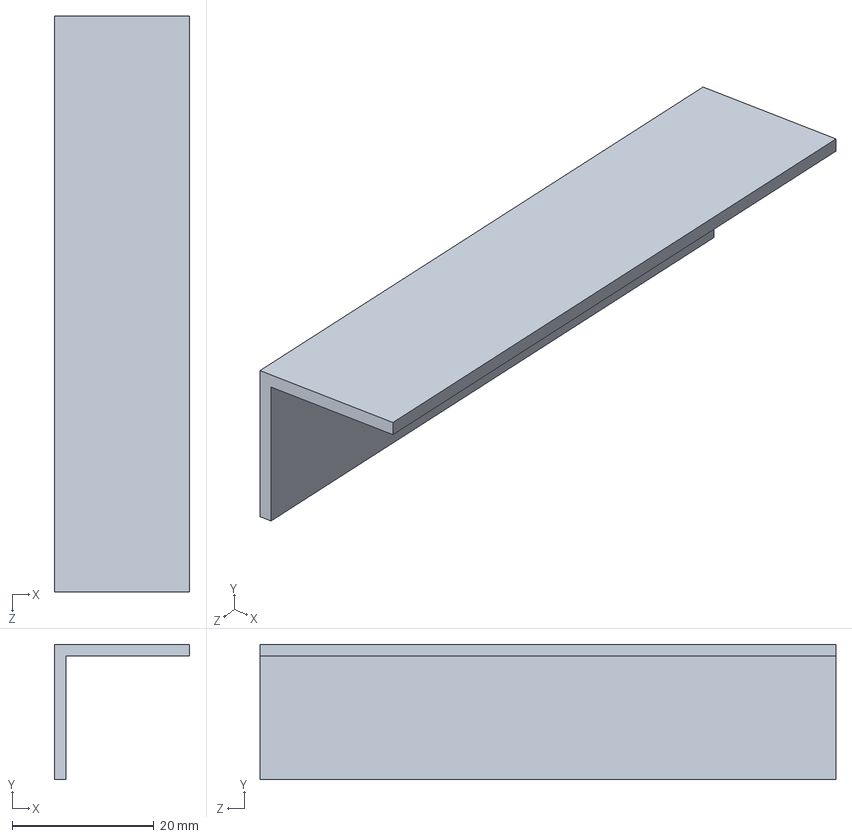
[picture p109: CAD file, 2017-07-01]
3-4 brace for top intake.SLDPRT
19.1 x 19.1 x 81.3 mm
