Sabercat-Robotics-4146-FRC/Master-CAD-2017/Angle Piece for Climber Side Plate uncut.SLDPRT

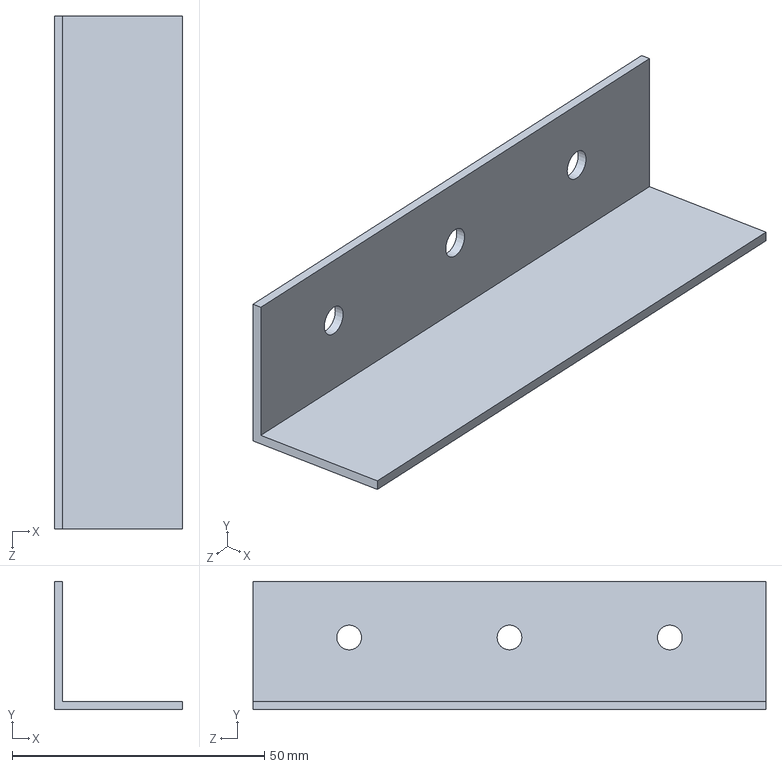
[picture p110: CAD file, 2017-07-01]
Angle Piece for Climber Side Plate uncut.SLDPRT
25.4 x 25.4 x 101.6 mm
