Sabercat-Robotics-4146-FRC/Master-CAD-2017/Gear_v2_mock pivot hinge leaf plus pin.SLDPRT

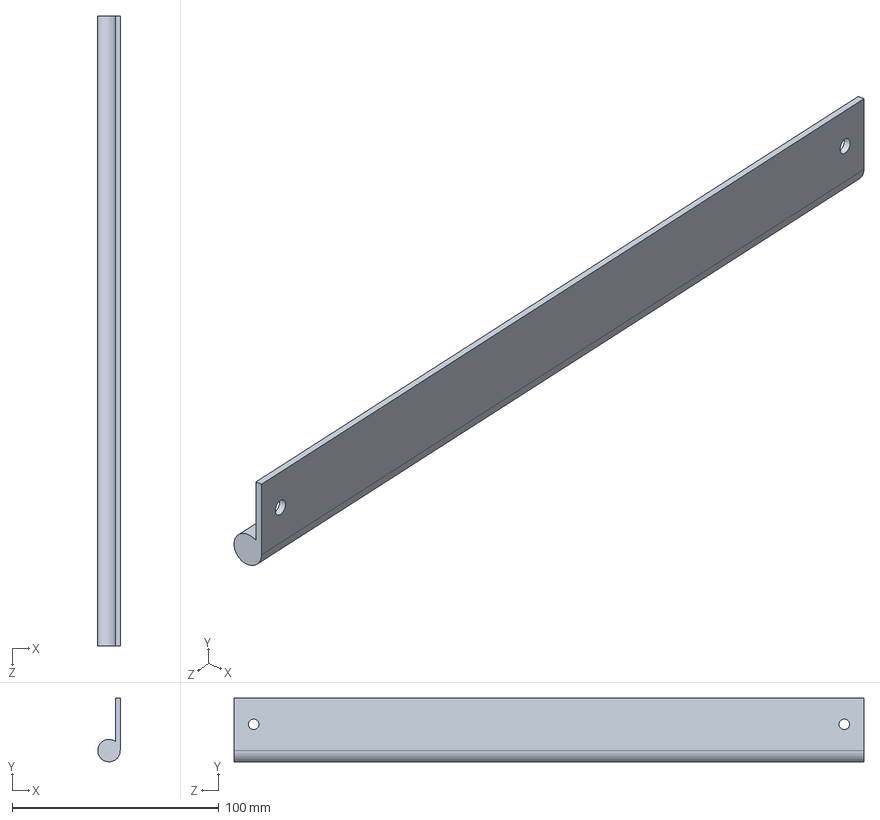
[picture p111: CAD file, 2017-07-01]
Gear_v2_mock pivot hinge leaf plus pin.SLDPRT
10.9 x 30.9 x 304.8 mm
