Sabercat-Robotics-4146-FRC/Master-CAD-2017/Shooter 16in hex shaft.SLDPRT

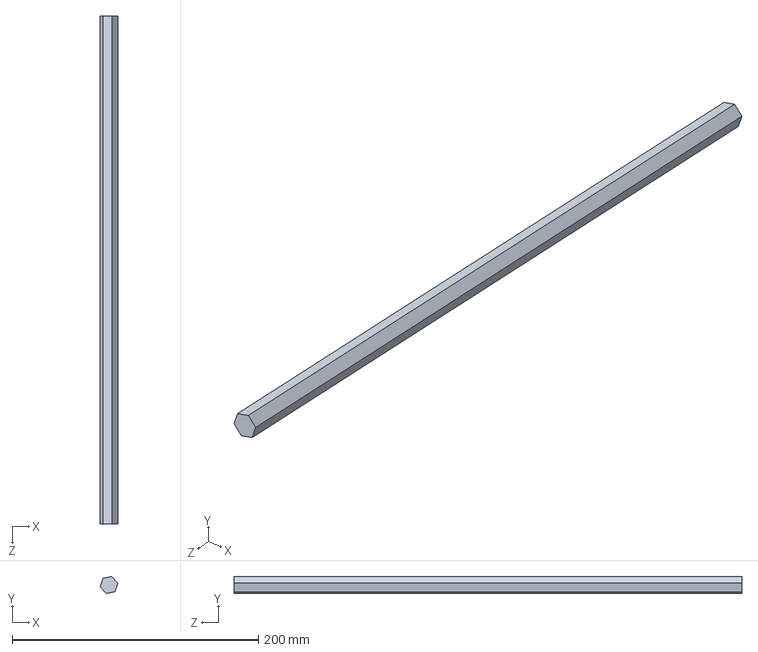
[picture p112: CAD file, 2017-07-01]
Shooter 16in hex shaft.SLDPRT
14.4 x 13.9 x 412.2 mm
