Sabercat-Robotics-4146-FRC/Master-CAD-2017/217-2625-003 Rev1.sldprt

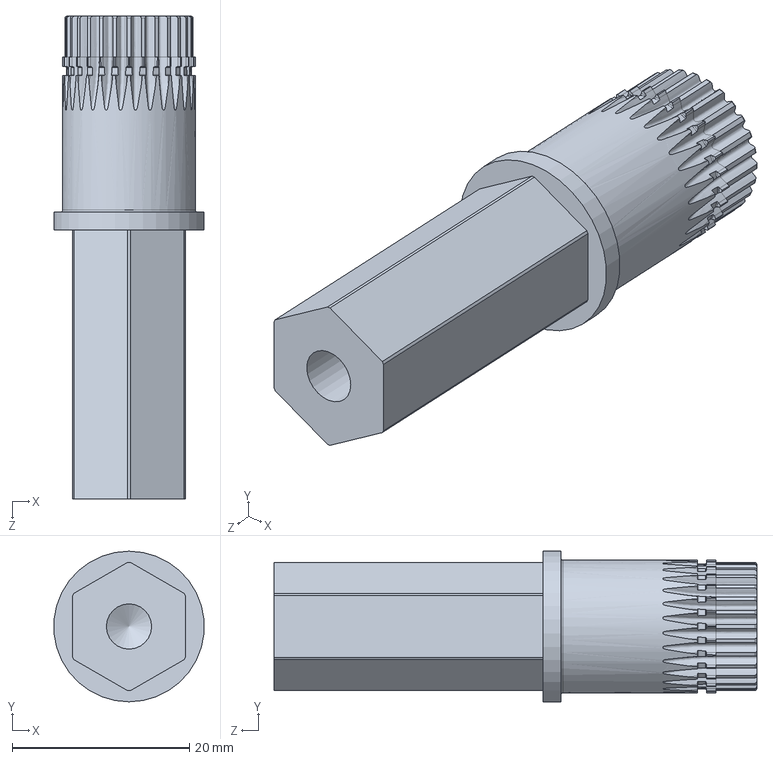
[picture p113: CAD file, 2017-07-01]
217-2625-003 Rev1.sldprt
16.9 x 17.0 x 54.5 mm
