Sabercat-Robotics-4146-FRC/Master-CAD-2017/Shooter Banebots Wheel T81P 4-875.SLDPRT

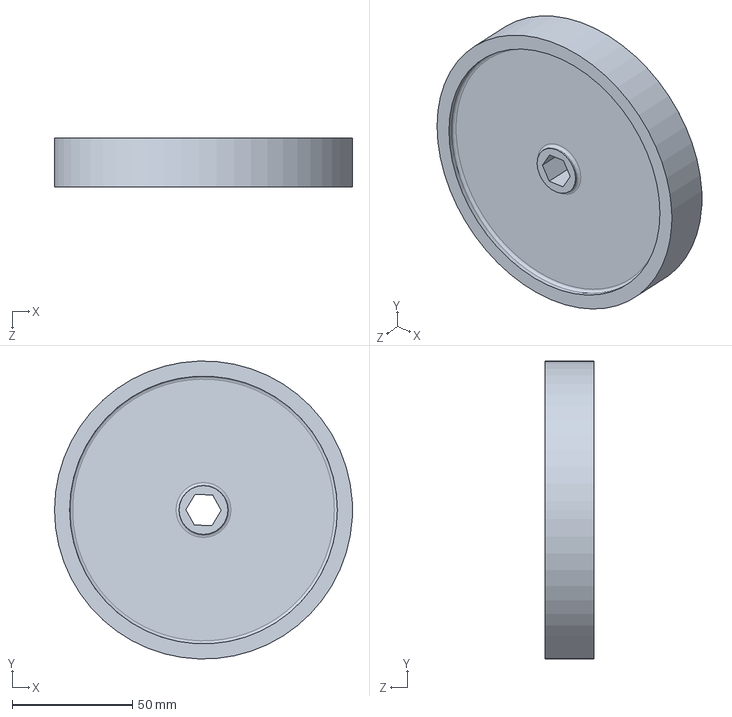
[picture p114: CAD file, 2017-07-01]
Shooter Banebots Wheel T81P 4-875.SLDPRT
123.8 x 123.8 x 20.3 mm
