Sabercat-Robotics-4146-FRC/Master-CAD-2017/217-4783-002 Rev7_Sealed Config.sldprt

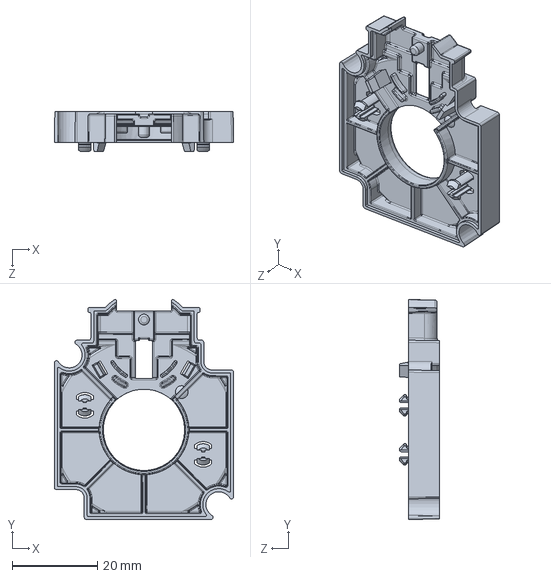
[picture p115: CAD file, 2017-07-01]
217-4783-002 Rev7_Sealed Config.sldprt
42.0 x 51.5 x 9.30 mm
