Sabercat-Robotics-4146-FRC/Master-CAD-2017/Shooter Friction Plate.SLDPRT

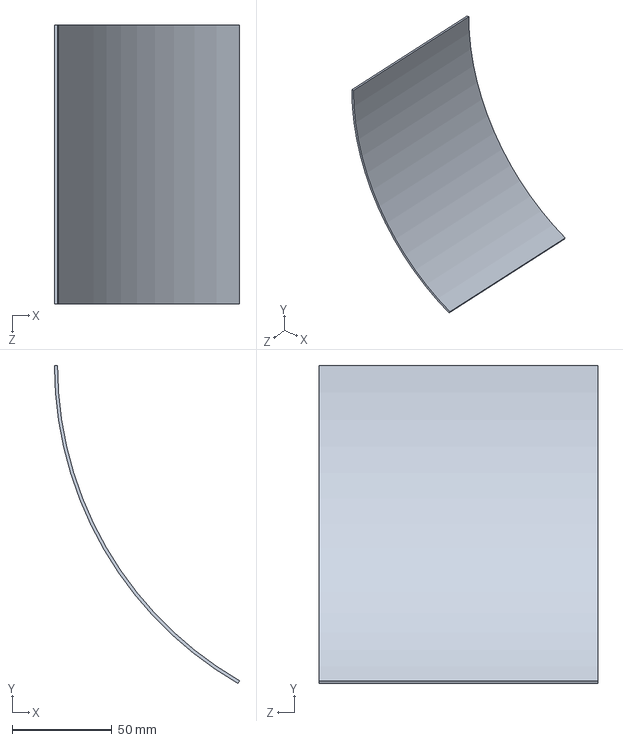
[picture p116: CAD file, 2017-07-01]
Shooter Friction Plate.SLDPRT
92.9 x 159.5 x 139.7 mm
