Sabercat-Robotics-4146-FRC/Master-CAD-2017/217-3232 Timing Pulley 36T 15mm.SLDPRT

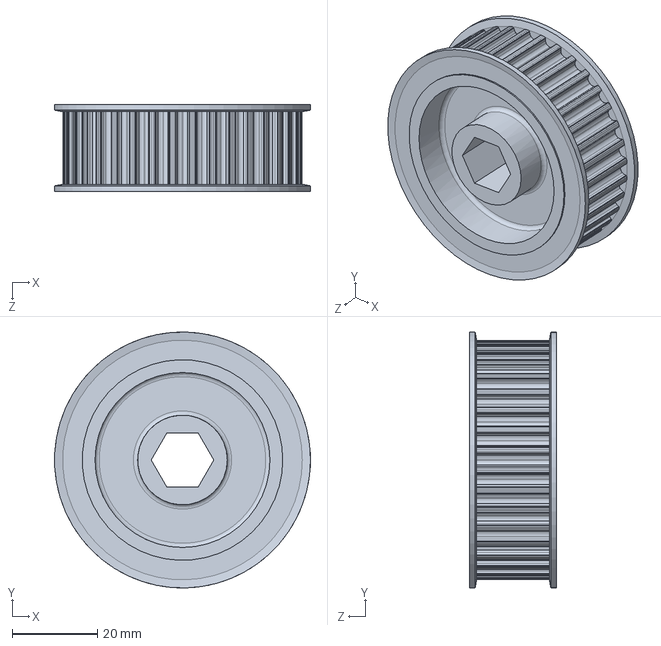
[picture p117: CAD file, 2017-07-01]
217-3232 Timing Pulley 36T 15mm.SLDPRT
60.0 x 60.0 x 20.5 mm
