Sabercat-Robotics-4146-FRC/Master-CAD-2017/Fake RoboRio.SLDPRT

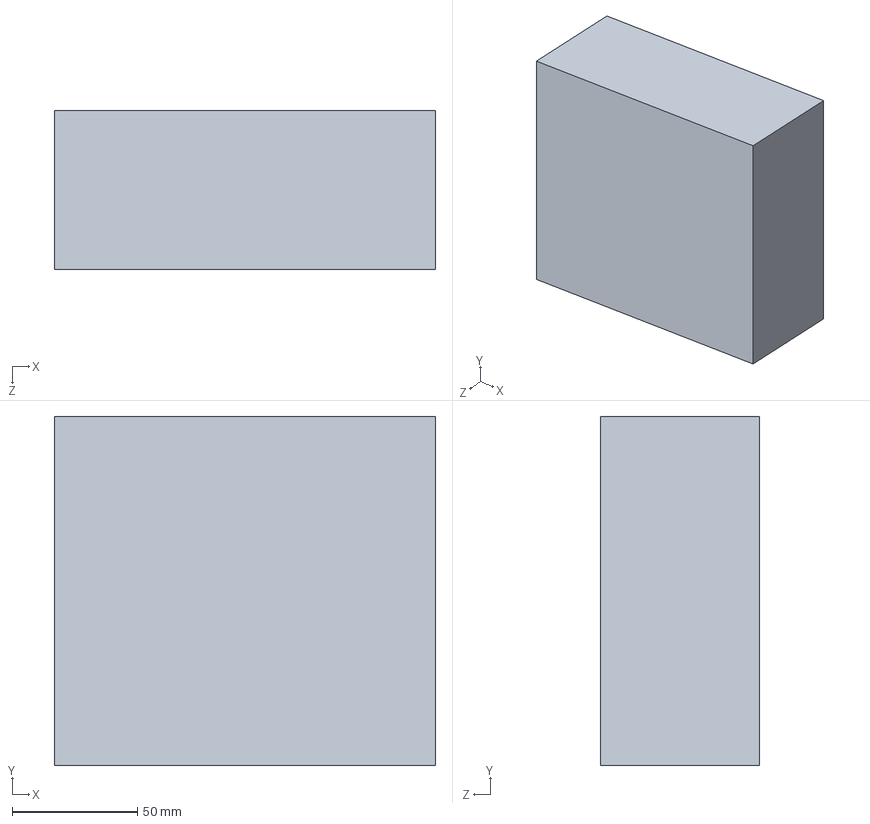
[picture p118: CAD file, 2017-07-01]
Fake RoboRio.SLDPRT
152.4 x 139.7 x 63.5 mm
