Sabercat-Robotics-4146-FRC/Master-CAD-2017/(list of files, cad)

Other CAD files:
Pneumatic Hub.sldasm
217-2625-100.sldasm
217-2820 Rev1_Public.sldasm
217-3141-007 Rev1_30T 32DP.sldprt
217-4649-002 Rev1_SSA0832-0500ZC.sldprt
PCBA Rev3.sldprt
217-4783-007 Rev1.sldprt
217-4783-006 Rev3.sldprt
SSS1032-0188-ZB.sldprt
217-4008-001 Rev1.sldprt
BB RS775-18V.sldprt
AM-2235 output shaft.sldprt
217-2625-013 Rev1.sldprt
217-2625-005 Rev1_Planet_Revolving_Follower01.sldprt
14-20x0500_bhcs.sldprt
217-4008-002 Rev1_91251A108.sldprt
8mm_spring_clip.sldprt
AM-2235 motor.sldprt
Inner Drive Train Plate.SLDPRT
Toughbox_d08.sldprt
217-2625-010 Rev1.sldprt
217-2625-026 Rev1.sldprt
217-2741.sldprt
Toughbox_d07.sldprt
AM-2235 gear cap.sldprt
217-4783-003 Rev4.sldprt
SSA_SSAM4-0010ZC.sldprt
ip-3302 10T gear.sldprt
fr-8-zz.sldprt
Toughbox_d09.sldprt
Toughbox_d05.sldprt
Toughbox_d03.sldprt
10-32x0625_shcs.sldprt
Gear_v2 left door true.SLDPRT
AM-2235 gearbox housing.sldprt
Valve.sldprt
217-4783-005 Rev7_40t_spur_REF_14deg.sldprt
Left Side Gear Clamp.SLDPRT
Hub.sldprt
217-2788-001 Rev3_57155K375.sldprt
217-2625-007 Rev1_Public.sldprt
217-4783-008 Rev2.sldprt
217-3141-006 Rev1_30T 32DP.sldprt
217-3141-004 Rev1.sldprt
217-2742-001 Rev4.sldprt
#4x1.00, Plastic Thread Rolling Screw, Pan Head, Cross Recessed, Zinc Plated (Plastic Applications)_.sldprt
1-2 Intake brace.SLDPRT
1.125 od .375 id bearing.SLDPRT
10-32_nylock_nut.sldprt
125x124x700_key.sldprt
217-2625-008 Rev1.sldprt
217-2737 Shaft Collar.SLDPRT
217-2816-001 Rev1.sldprt
217-3141-001 Rev1.sldprt
217-4783-001 Rev3.sldprt
217-4783-004 Rev2_40t_spur_REF_14deg.sldprt
250_washer.sldprt
5-16_washer.sldprt
832-1750-Ring-Gear-Screw_SSA0832-0500ZC.sldprt
9mm 24t pulley half.SLDPRT
AM-2235 threaded insert.sldprt
Back Bumper Test Piece.SLDPRT
Banebots T40P 1-875.SLDPRT
Center Pulley.sldprt
Climber Baseplate.SLDPRT
Climber Hex Shaft.SLDPRT
Fake Rev Robotics Spark.SLDPRT
Front to Shooter Brace.SLDPRT
Gear_v2_Mock door hinge leaf only.SLDPRT
Gear_v2_Right Ramp.SLDPRT
Gear_v2_linkage rod.SLDPRT
Gear_v2_support plate.SLDPRT
Intake Backing Plate.SLDPRT
Intake Drive Belt.SLDPRT
NUT-832-NYLOCK.sldprt
Outside Drive Train Plate Left.SLDPRT
Outside Drive Train Plate.SLDPRT
PINL-M020-006-S.sldprt
Part1.SLDPRT
Rear Ball Roller Plate.SLDPRT
SSA_SSA0832-0750ZC.sldprt
Servo mounting block.SLDPRT
Snow Blower motor Hub.SLDPRT
Tire.sldprt
Toughbox_d06.sldprt
Upper Belly Pan.SLDPRT
am-1291 screw_90190A196.sldprt
fr-6-zz.sldprt
r6zz.sldprt
